bramhut/FlexBMS/Software/Companion/README.md

# FlexBMS Companion

The FlexBMS-only Companion has two compile-time targets. `npm run build:webserial`
creates the direct USB/Web Serial development build; `npm run build:gateway`
creates the committed ESP32 Gateway bundle under `dist/gateway` and its manifest.

The Gateway serves the latter on the trusted local LAN only. It is not an HV
safety authority. The Firmware page supports Gateway-assisted updates from a
FlexBMS bundle; STM32 updates require the station LAN. USB/ST-Link release
flashing remains available for recovery. The Web Serial target uses the same CRC-framed BMS v1 protocol as the
Gateway UART link; it requires a Chromium-family browser with Web Serial.

The Gateway target also exposes **Configuration > RS485 energy meters** for
the optional zero/one/two SDM72D-M-2 extension. Configuration is Gateway-local,
persists without a reboot, and requires the trusted station LAN. Direct USB
does not expose this capability. See the
[meter specification](../../Documentation/architecture/rs485-energy-meters.md)
for settings, reported values, HA discovery and commissioning.

The views share a responsive layout in both builds. Configuration groups the
battery, current sensor, and operating settings, shows unsaved changes, and
offers **Discard changes**. Shunt settings appear only when current sensing is
enabled. Wi-Fi and MQTT show connection summaries with explicit **Edit** forms;
live Gateway status updates preserve an open MQTT draft. Technical information
remains available in expandable details. Slave labels use numbering from 1 in
the UI; register requests and CSV indices retain their zero-based protocol form.

For a local UI preview, run `npm run dev -- --host 127.0.0.1 --port 5178` and open
`http://127.0.0.1:5178/tests/ui/companion.html`. It renders the actual view
components with sample telemetry and mock services. Preview controls exercise
connection loss, unavailable capabilities, configuration drafts, faults,
activity, and CSV snapshots. Local firmware bundles can be inspected, but
installation is blocked. This fixture is excluded from production builds.

`npm run build:desktop` produces a portable Windows executable below a new
timestamped `electron-dist/build-*/` directory and prints its exact path. It is
a thin Electron/Chromium wrapper around the direct USB Web Serial target: it
has no installer, updater, or native serial-protocol implementation. It is
deliberately unsigned and disables Electron-builder's Windows executable
signing/resource-editing pass, so packaging does not wait on `signtool`.
`../../scripts/build-release.ps1` builds that executable, the Gateway factory
image, and the STM32 image together, then writes them and SHA-256 hashes below
`release/FlexBMS-<version>/`. When run interactively, it prompts for the
release version; entering a new semantic version updates `package.json` and
`package-lock.json` before building. Use `-Version 0.1.1` for unattended use.
An existing version requires an explicit timestamped-repeat choice, so prior
artifacts are never overwritten.

Every release directory includes `flash-release.ps1`. Use `-Target Stm32` with
an ST-Link/SWD connection, `-Target Gateway -GatewayPort COM6` for the ESP32-C3
USB bootloader, or omit `-Target` to flash both. The script verifies release
hashes before erasing and flashing either controller.
