bramhut/FlexBMS/tmp/pdfs/bms-report-35.png

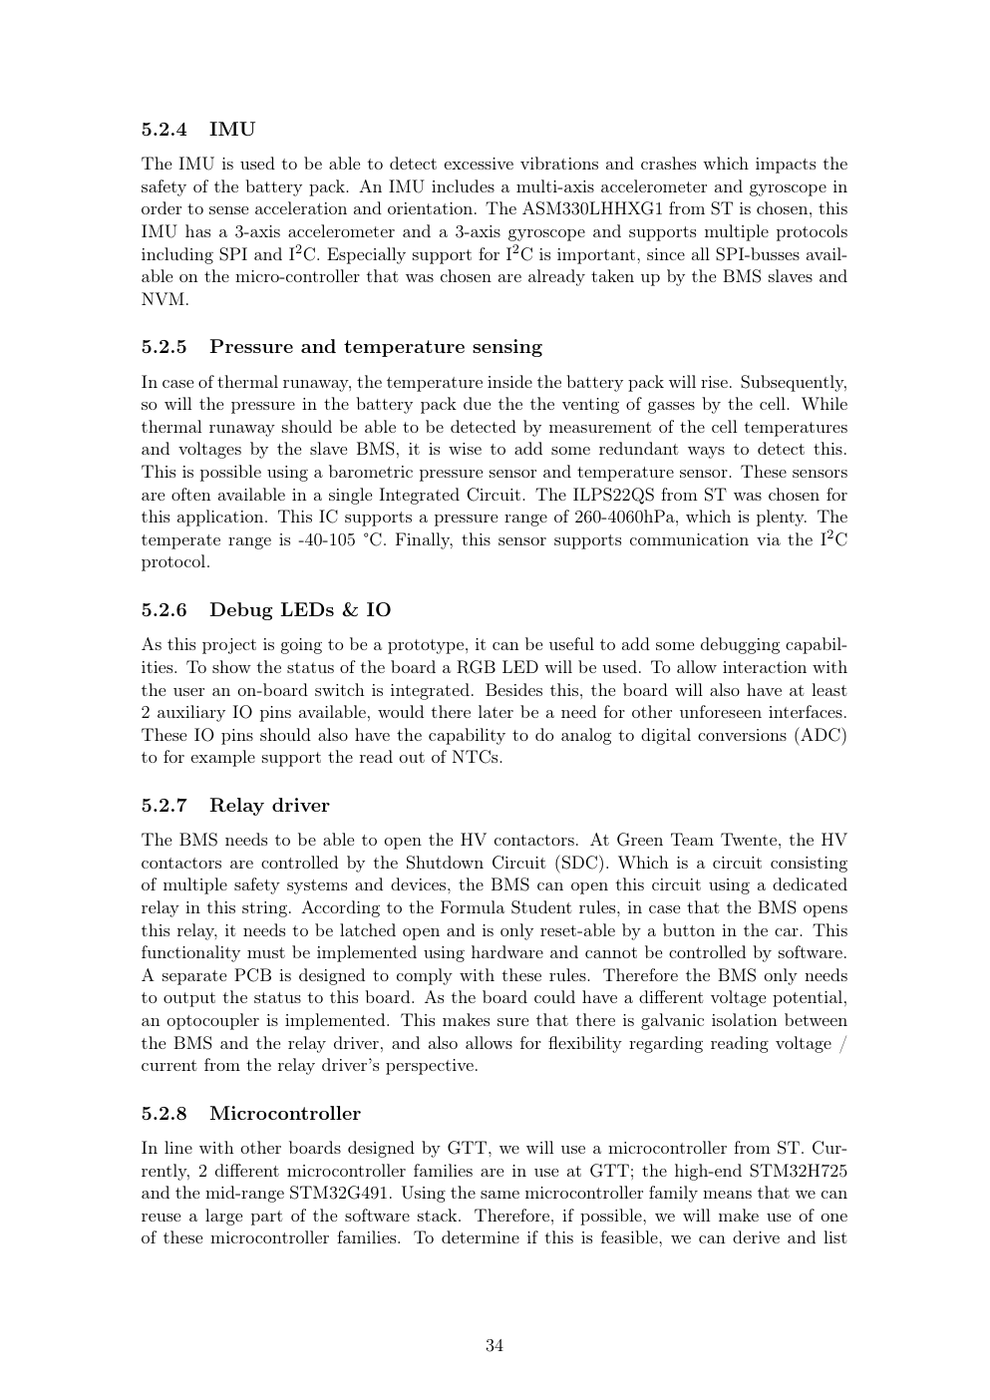
tmp/pdfs/bms-report-35.png
