bramhut/FlexBMS/tmp/pdfs/bms-report-36.png

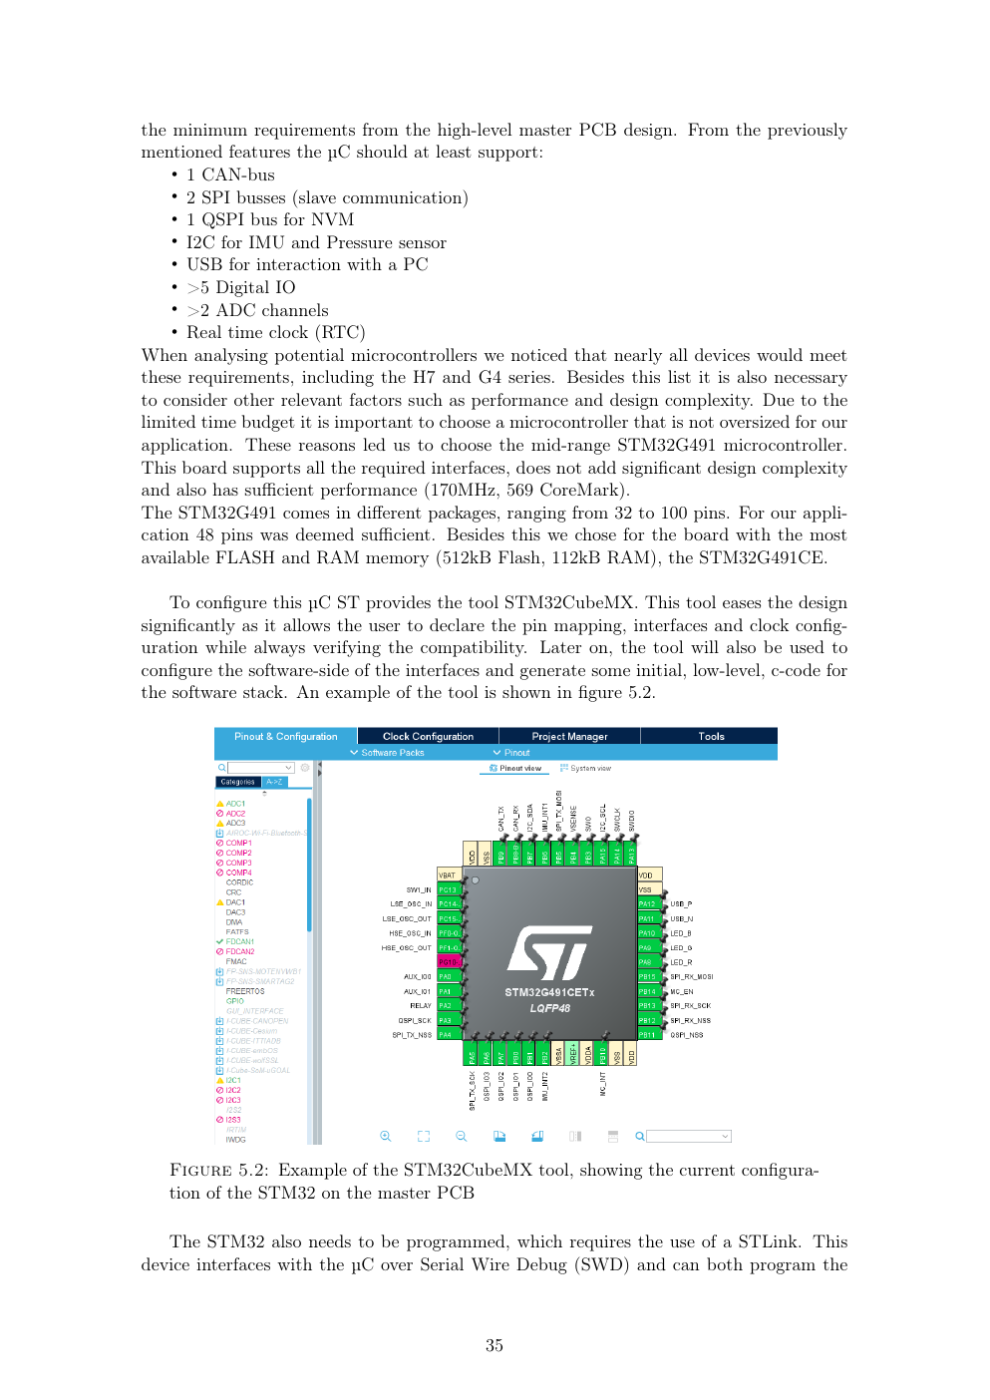
tmp/pdfs/bms-report-36.png
