bramhut/FlexBMS/tmp/pdfs/bms-report-37.png

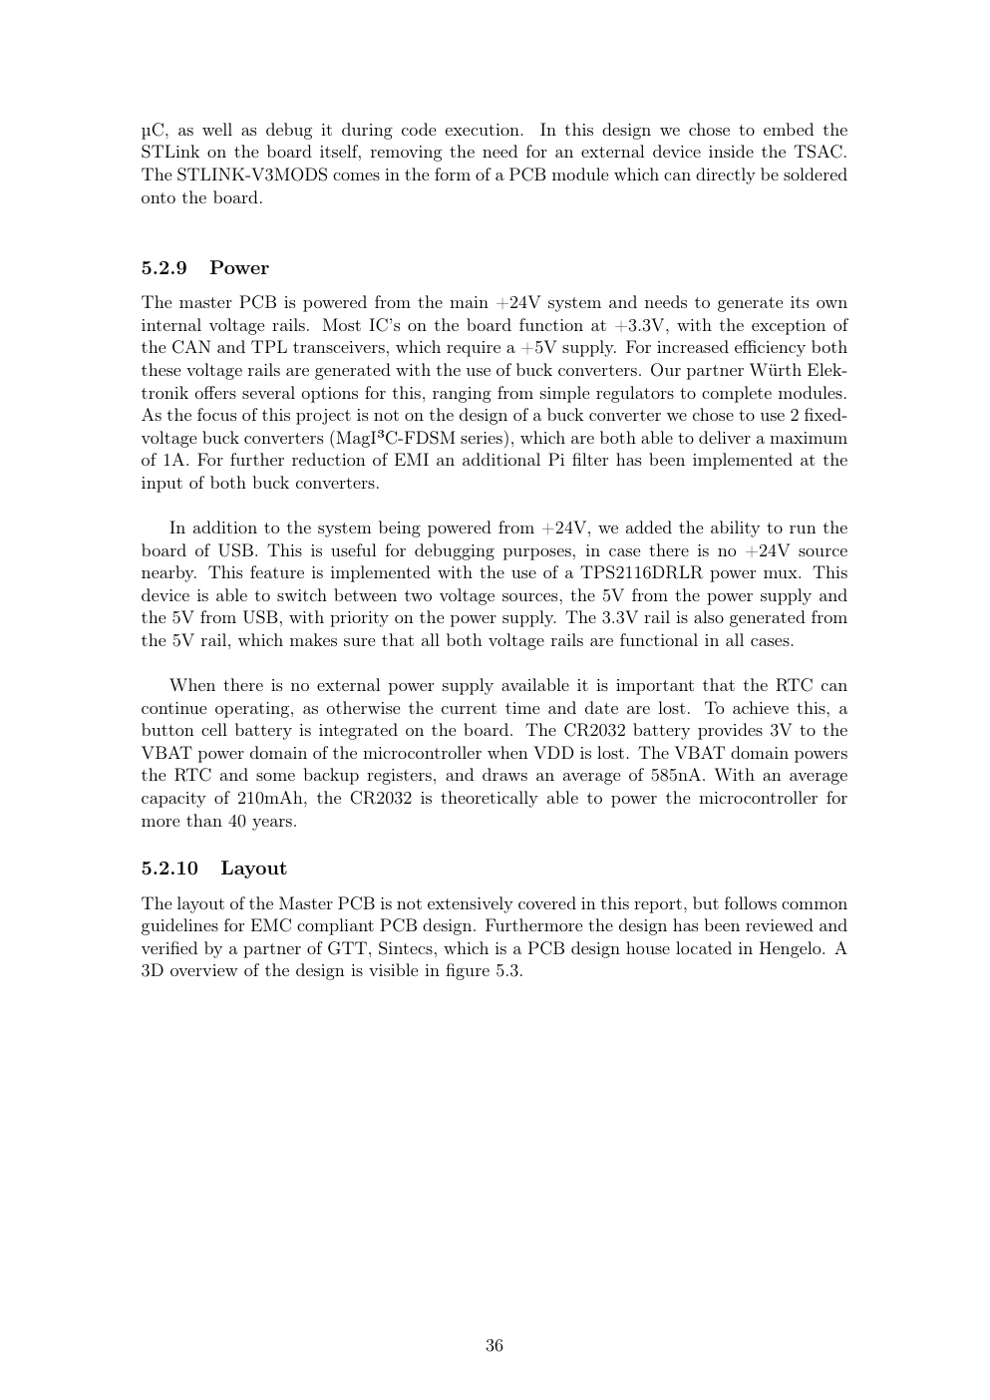
tmp/pdfs/bms-report-37.png
