bramhut/FlexBMS/tmp/pdfs/bms-report-38.png

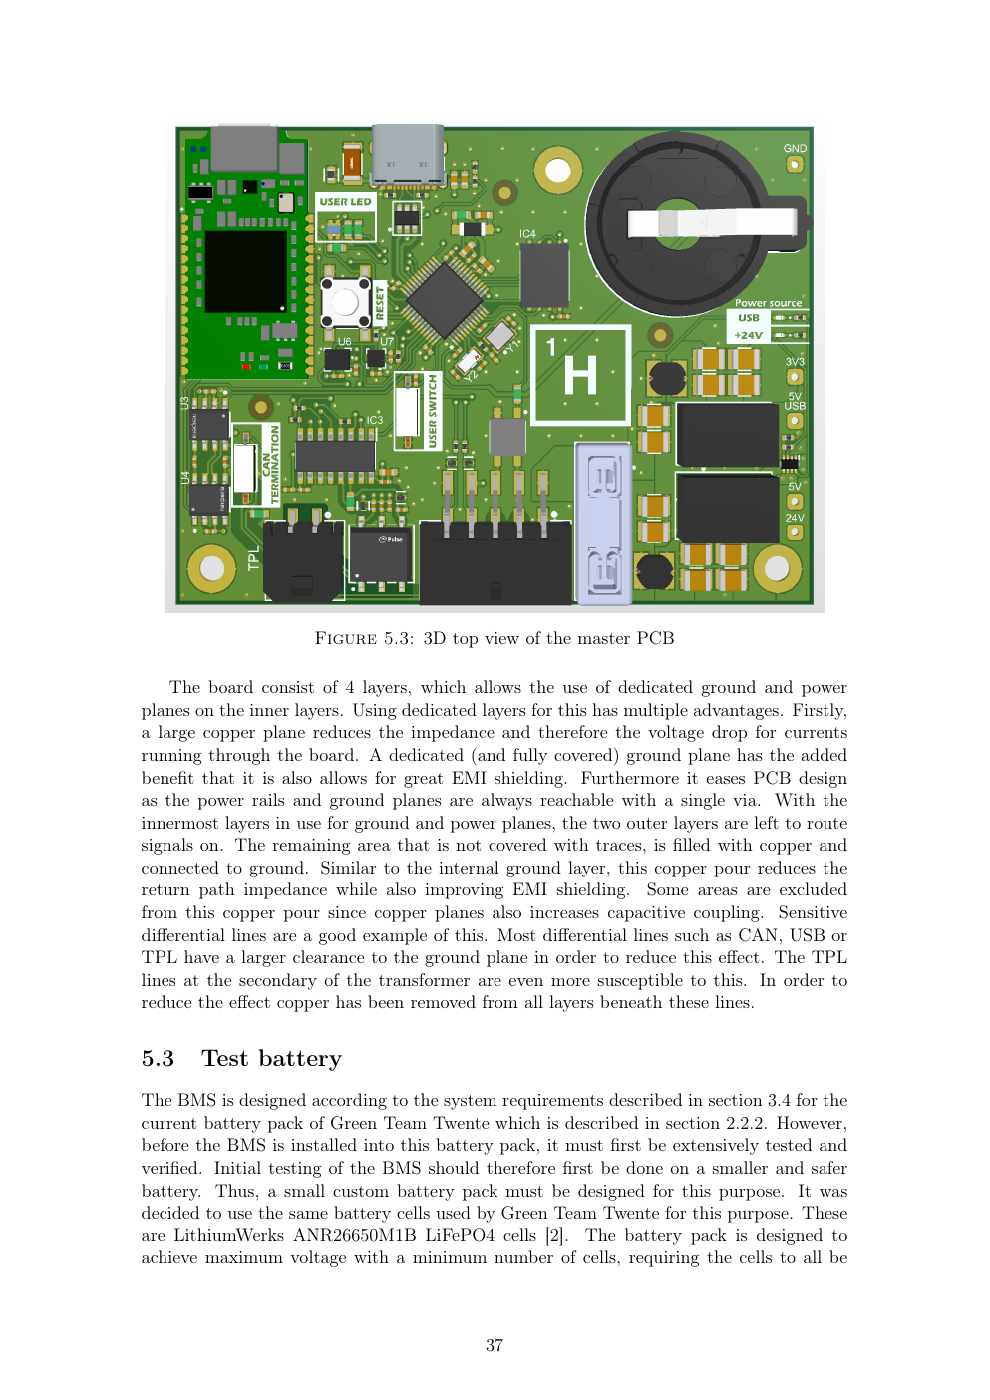
tmp/pdfs/bms-report-38.png
