bramhut/FlexBMS/tmp/pdfs/overview-12.png

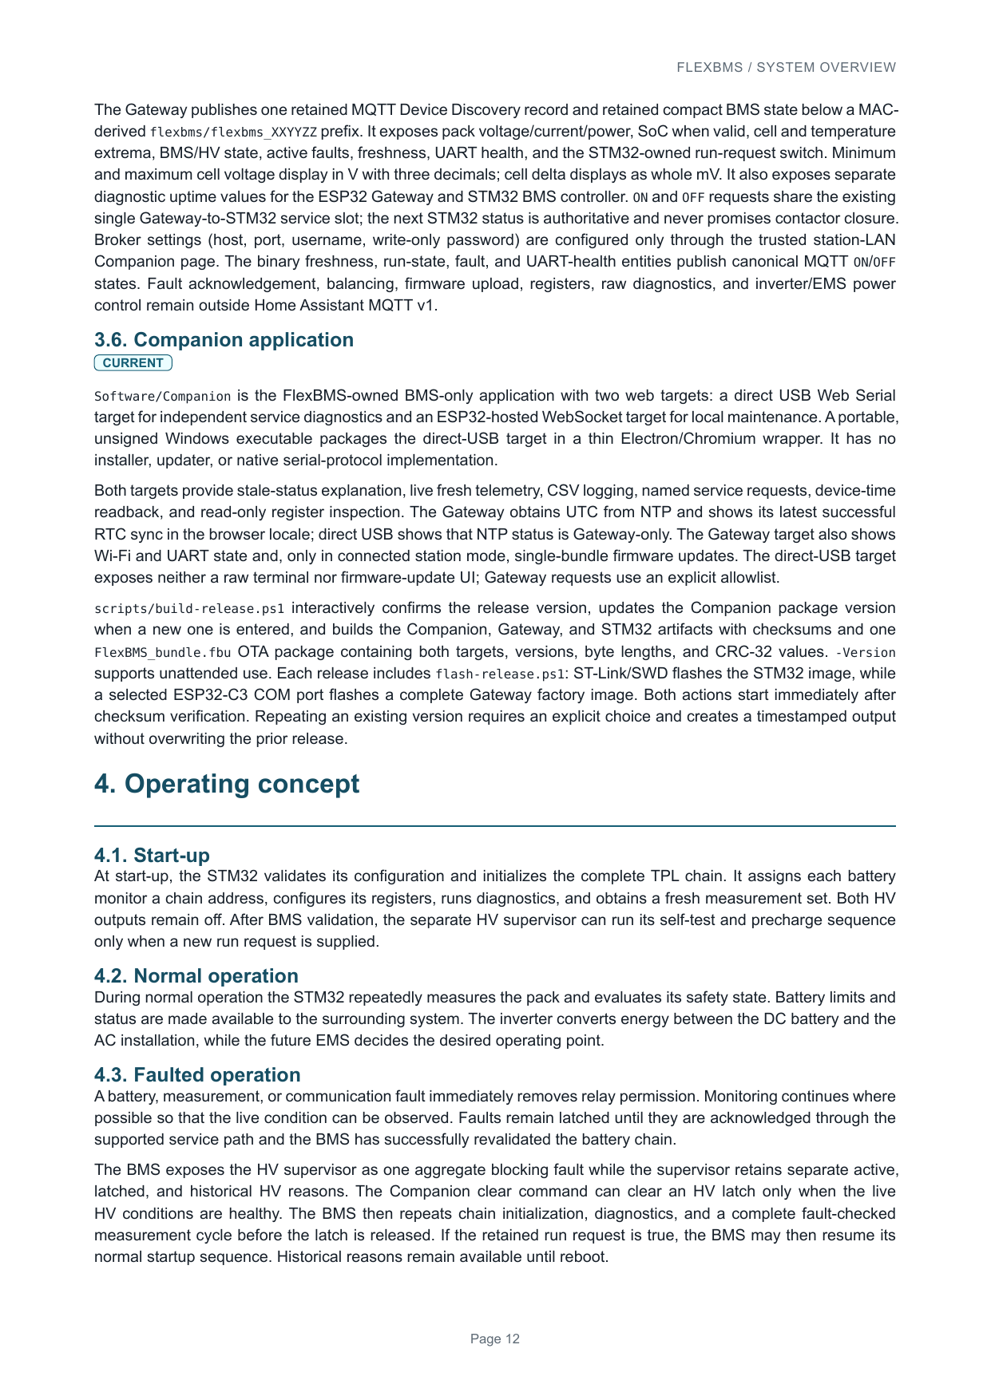
tmp/pdfs/overview-12.png
