bramhut/FlexBMS/Documentation/architecture/home-bess-firmware-and-maintenance.md

# Home-BESS firmware and maintenance architecture

## Status and scope

This is the agreed target architecture for FlexBMS Home-BESS software. It is a
design document, not a statement that the described ESP32, update, or web
software exists yet. It does not change the hardware safety chain.

The STM32G491 BMS communicates with the GoodWe GW12K-ET-20 over CAN. The
ESP32-C3 connects to the STM32 through the existing isolated UART link. The
ESP32 may passively observe the shared BMS/GoodWe CAN bus for diagnostics, but
never transmits on it.

## Safety and ownership

| Component | Owns | Does not own |
|---|---|---|
| STM32 BMS | Measurements, fault evaluation, HV permission, contactor safety, GoodWe CAN, final validation of all service requests | Wi-Fi, MQTT, Home Assistant availability |
| ESP32 Gateway | Local network, MQTT, web service, UART transport, ESP32 OTA, STM32 update orchestration | Battery safety decisions and BMS/GoodWe CAN transmission |
| FlexBMS Companion | Independent maintenance UI and named diagnostics/service requests | Raw network commands or safety decisions |
| Home Assistant | Dashboards, notifications, firmware/status display, maintenance-page link | Firmware upload, contactor control, or any safety dependency |

Loss of the ESP32, Wi-Fi, MQTT, Home Assistant, or the browser must never
prevent the STM32 from protecting or isolating the battery.

## Gateway Wi-Fi maintenance path

Wi-Fi configuration is an ESP32/Gateway maintenance function, not a battery
control path. The Gateway-hosted Companion can change credentials while it is
on the trusted LAN and can recover through an open, temporary setup AP. Neither
operation is sent to the STM32 or changes its safety ownership.

On first use the Gateway exposes `FlexBMS-Setup-XXYYZZ` at `192.168.4.1` until
configured. After a saved station network fails to acquire an IP for 30
seconds, it exposes the same AP for ten minutes while retrying station mode;
it then retries station-only for one minute and repeats until connected. The
AP offers best-effort captive-portal DNS/HTTP behaviour, although users may
need to open `http://192.168.4.1` manually on HTTPS-only clients.

The AP is deliberately open and credentials reside in ordinary ESP32 NVS.
While it is active, the Companion is monitor and Wi-Fi-configuration only:
Gateway-to-STM32 service controls are disabled. Detailed API and validation
requirements are in the Companion/Gateway specification.

## Operating request

The STM32 owns one volatile `run_request` flag. Both Companion transports and
the later Home Assistant switch use the same named `setRunRequest(true|false)`
operation; it is intent, never a direct contactor command.

The STM32 may operate the HV path only when `run_request` is true and all BMS
and HV-supervisor conditions are healthy. It is the STM32, not the requesting
client, that advances `OFF -> SELF_TEST -> PRECHARGE -> CONTACTOR_CLOSE -> RUN`.

A blocking fault immediately removes effective HV permission but does not erase
`run_request`. After the user explicitly clears faults and the STM32 completes
its required revalidation, the BMS may resume the startup sequence when the
request is still true. Switching the request off never clears faults.

The flag defaults off only after an STM32 reset. The Gateway serialises
state-changing requests so there is one active writer while any number of
clients may monitor. Telemetry must report the requested state, actual HV
state, and a concise blocking/rejection reason separately.

## Startup diagnostics and remote inspection

Startup diagnostics validate the monitor chain before fresh measurements and
HV readiness are available. They run independently of the volatile Run request;
passing diagnostics does not enable HV.

Each slave's configured temperature inputs occupy GPIO0 through
GPIO(NTC_COUNT-1). The GPIO open-terminal test retains the raw result for all
seven GPIOs, but only an open configured temperature input fails startup.
For example, four fitted inputs give a checked mask of `0x0F`; an open mask of
`0x70` identifies unused GPIO4–6 and is expected. An open mask containing any
bit in `0x0F` still blocks startup.

Failed diagnostics use a non-blocking two-second retry delay, then repeat
device initialization, CID assignment and register initialization. The delay
exceeds the monitors' 1024 ms communication-reset timeout, so diagnostic retries
must not reuse the old CID assignments or modified diagnostic registers.

ADC conversion waits compare unsigned elapsed times from the per-slave and
global conversion starts. This keeps retained startup-test timestamps valid
across the 32-bit microsecond timer's approximately 71.6-minute rollover.
The wait is limited to the remaining conversion duration; an already elapsed
conversion adds no delay. The 500 ms safety watchdog remains unchanged.

Companion's **Diagnostics → Hardware & tools** view shows the startup reports,
including register context and the raw/checked GPIO masks. Opening Diagnostics
refreshes the reports, including successful results. The first failed result
per slave is retained until STM32 restart so later communication failures cannot
replace it. Reports are historical; the dashboard's Status reports live faults.
Read-only register requests are serviced between startup/retry iterations by
the BCC task that already owns the SPI interface.

For Gateway-only investigation, run the following from the repository root:

```powershell
.\scripts\read-startup-diagnostics.ps1 -GatewayUrl http://GATEWAY_ADDRESS/ -OutputPath diagnostics.json
```

The capture reads controller versions, runtime configuration, status and each
slave's diagnostic report over the Gateway WebSocket. It does not change Run,
configuration or fault acknowledgements. Each service result is included;
`busy` or `denied` is not a passed diagnostic. `status_observed_at` timestamps the
status sample; `captured_at` and `completed_at` bound the whole capture.
`-TimeoutSeconds` sets a bounded capture deadline (60 seconds by default).
The wire fields and compatibility forms are specified in
[`../protocol/uart-v1.md`](../protocol/uart-v1.md).

## Repository layout and release ownership

FlexBMS owns the BMS-only Companion source because it releases alongside the
STM32 and Gateway interfaces. The external HyDriven Companion remains useful
as historical/reference code, but is not a release dependency or submodule.

~~~text
Software/
  Master/                 STM32 BMS firmware
  Gateway/                ESP32 firmware, MQTT, HTTP/WebSocket, OTA, UART bridge
  Companion/              FlexBMS-only Vue maintenance application
    src/                  shared BMS UI and transports
    dist/                 versioned generated bundles consumed by Gateway builds
  protocol/               transport specification, message catalogue, test vectors
Documentation/
  architecture/          this architecture
  operations/            commissioning, update, and recovery procedures
~~~

The obsolete in-tree Companion copy has been removed. A Gateway release
consumes a versioned committed Companion bundle so a local Gateway build
remains offline and reproducible.

## Companion: one UI, two web targets

The shared UI has a transport interface for connection lifecycle, live messages,
named requests, and declared capabilities. BMS views do not depend on the
physical transport.

~~~text
FlexBMS Companion shared BMS UI
  |- companion-webserial: Chromium Web Serial -> USB -> STM32
  |- companion-gateway:  Browser WebSocket -> ESP32 -> isolated UART -> STM32
  '- companion-desktop:  Portable Electron/Chromium wrapper -> Web Serial -> USB -> STM32
~~~

companion-webserial is the direct-service fallback. It exposes the same named
BMS actions as the Gateway build and has no raw-terminal or firmware-update
interface.

companion-desktop packages the direct-USB target as a portable, unsigned
Windows executable. It is not an installer and has no updater or native serial
protocol implementation; Electron provides Chromium and Web Serial only.

companion-gateway is the ESP32-hosted local maintenance page. It provides
monitoring, named service actions, Gateway status, and Wi-Fi configuration. It
does not include a raw terminal and the Gateway rejects unknown or raw requests
even if a browser client attempts to send them.

Both builds support stale-status explanation, live BMS monitoring, register
reads, Gateway NTP RTC sync and device-time readback, fault-clear requests,
the immediate BMS run-request switch, browser-local CSV logging, and a live
GoodWe CAN diagnostic panel. The panel shows STM32 TX-queue acceptance/timing,
transmit failures, FDCAN error counters and bus state, skipped CAN cycles, the
exact current sent in `0x458`, and raw inverter responses `0x420`, `0x425`, and
`0x305`; the same data is included in the CSV log. The Gateway build additionally offers Gateway
Wi-Fi/link diagnostics. Its page prominently identifies the active connection
as either Direct USB to STM32 or Via ESP32 Gateway and disables capabilities
not available on that path.

The FlexBMS build removes HyDriven branding, unrelated vehicle-device views,
and Electron self-update UI. The initial stored Gateway bundle budget is 500
KiB. This is below the measured approximately 940 KiB stored size of the
unmodified multi-device Companion build. `scripts/build-release.ps1` runs the
Companion checks, packages the desktop executable, builds Gateway firmware,
and places `FlexBMS-Companion.exe`, `FlexBMS-Gateway.bin`,
`FlexBMS-Gateway-factory.bin`, `FlexBMS-STM32.bin`, `flash-release.ps1`, and
`SHA256SUMS.txt` in `release/FlexBMS-<version>/`. The interactive command
prompts for a plain `major.minor.patch` version and synchronizes it to the Companion
package files and STM32 version header; `-Version` supports unattended builds.
Existing release directories are preserved: increment the patch version for a
new build. Release names have no timestamp or version suffix. The script does
not flash hardware.

`flash-release.ps1` is copied into every release directory. It verifies all
release checksums before acting, then uses STM32CubeProgrammer over ST-Link/SWD
to write and verify the STM32 application at `0x08000000`. For the ESP32-C3 it
uses `esptool.py` on a chosen COM port to erase and flash the complete Gateway
factory image. Flashing starts immediately after checksum verification; close
serial monitors and manually enter the ESP32-C3 bootloader when necessary.
The factory-image builder takes the Gateway application address from the
`ota_0` row in `Software/Gateway/partitions.csv` (currently `0x20000`), rather
than using ESP-IDF's conventional `0x10000` default. It verifies that the
merged factory image contains the ESP image magic at that exact address before
writing release checksums. Normal PlatformIO Gateway uploads use the same
partition-derived offset.

## Gateway web and network service

The ESP32 serves the Gateway Companion bundle and its API on the trusted local
LAN. It uses unauthenticated local HTTP and WebSocket by design; the router
must not expose the device to the Internet. A local page is preferred to an
externally hosted UI because it remains usable without Internet, Home
Assistant, or a separate server.

When unprovisioned, the Gateway provides a temporary setup access point and
setup page. After credentials are stored it uses station mode on the local LAN.

Named Gateway service actions in the first release are:

- read a BMS register;
- synchronise the RTC;
- set the BMS run request;
- submit a fault-clear request; and
- configure or scan local Wi-Fi through the Gateway when its Wi-Fi capability
  is available.

Full runtime configuration writes are permitted only through the local
Companion service path while the HV system is safely off. The STM32 validates
and stores the complete candidate in its reserved FLASH area, applies it after reset, and
enters a blocking `NO_CONFIG`/safe-off state when the area is blank or its
schema version is incompatible. A single deliberate button press is
sufficient for a permitted local action; the STM32 remains responsible for
validating every requested state change. Wi-Fi, browser, MQTT, and Home
Assistant loss have no BMS safety effect in this stage.

## MQTT and Home Assistant

The Gateway uses Home Assistant MQTT Device Discovery, so Home Assistant needs
no YAML configuration. Its identity and state prefix are derived from the
Gateway Wi-Fi MAC as `flexbms/flexbms_XXYYZZ`; Discovery uses the standard
`homeassistant` prefix. The intended broker is the official Mosquitto Broker
add-on on Home Assistant OS. The Companion stores a normal local-broker host,
port, username, and write-only password in Gateway NVS. MQTT configuration is
available only on the trusted station LAN, never through the open setup or
recovery AP. The ESP32 reconnects when the broker returns and republishes
current discovery and diagnostic state after reconnect. Home Assistant, the broker, and
MQTT are not BMS safety dependencies.

Discovery/configuration and the combined diagnostic snapshot are retained. Gateway
availability uses MQTT last-will/offline status. An unavailable Gateway marks
the Home Assistant entities unavailable but does not alter the STM32 request or
safety state.

Home Assistant receives only compact aggregate telemetry and the maintenance
link; detailed cells, balancing state, registers, raw diagnostics, and the 128
KiB Gateway log remain in Companion. The initial entity catalogue is:

| Entity | Meaning |
|---|---|
| `switch.run_request` | Requested BMS operation only; never a contactor-state guarantee. |
| `sensor.hv_state` and `binary_sensor.hv_running` | Actual STM32 HV-supervisor state; `hv_running` is true only in `RUN`. |
| Pack sensors | Pack voltage, current, power, and SoC when valid; minimum/maximum cell voltage display in V with three decimals; minimum/maximum NTC temperature. |
| `sensor.cell_delta` | Maximum minus minimum cell voltage, published and displayed as whole mV. |
| `binary_sensor.fault_active` | On whenever any active or blocking BMS fault exists. |
| `sensor.active_faults` | Human-readable active fault names, or `No faults`. |
| Link sensors | ESP32 Gateway uptime, STM32 BMS-controller uptime, UART health, telemetry freshness, MQTT state, and Gateway availability. |
| Maintenance-page link | The discovered device links to the local Gateway Companion page. |

The `run_request` switch reports the STM32-owned retained intent. Its MQTT
command topic accepts only `ON` and `OFF`, is never retained, and shares the
Gateway's one active STM32 service slot with Companion and NTP. The Gateway
does not report an optimistic switch result: the next STM32 `STATUS` is the
authoritative state. Separate HV and fault entities show whether that intent is
presently effective. Home Assistant does not upload images or directly initiate
safety-related actions.

The four binary diagnostics (`telemetry_fresh`, `hv_running`, `fault_active`,
and `uart_healthy`) publish canonical MQTT `ON`/`OFF` states. Home Assistant
therefore reports a real state rather than `Unknown`; `fault_active` is `ON`
only for an active/blocking BMS or HV fault. Gateway uptime is the ESP32
microsecond timer converted to seconds; BMS-controller uptime is the STM32
`STATUS.uptime_ms` tick converted to seconds. Both reset on their respective
controller reset and are diagnostic only.

### Acquisition-based HA publishing (local increment, 12 October 2026)

The MQTT discovery identities, entity names, device identity and command topic
are unchanged. Acquisition-sensitive entities now override the common state
topic with one of the following topics beneath `flexbms/flexbms_XXYYZZ`:

| Topic | Entities / source |
|---|---|
| `state/status` | Run request, BMS/HV state, HV running, faults, telemetry freshness and STM32 uptime; newly decoded STATUS only |
| `state/pack` | Pack voltage/current/power/SoC, cell extrema and temperatures; newly decoded PACK only |
| `state/energy` | Charged/discharged energy; newly decoded ENERGY only |
| `state` | Legacy combined diagnostic snapshot and Gateway link diagnostics; **not acquisition proof** |

Live source packets are non-retained QoS 0: a missed packet waits for the next
UART acquisition rather than replaying an old QoS-1 outbox entry after reconnect.
The Gateway coalesces each source's newest decoded frame into its existing
one-second publication cycle. It consumes that source only when publication is
accepted; a failed local send may retry while the acquisition is under three
seconds old. Periodic ticks, unrelated frames and discovery cannot publish a
cached source. PACK/ENERGY require a recent STATUS with measurements-fresh set.
Malformed frames do not mark a source acquired. Invalid measurement status,
UART loss, MQTT reconnect/disconnect and HA birth discard pending acquisitions.
Fresh STATUS alone cannot resurrect a discarded PACK or ENERGY.

Live sensors/binary sensors use `force_update: true` for unchanged successful
acquisitions and a provisional ten-second expiry. The run-request switch has no
force-update or expiry option: its attributes carry the existing STATUS
`stm32_uptime_ms`, so unchanged intent receives a real HA write on a new status
tick. Its old displayed value is not readiness; consumers must enforce source
age. There is no new entity, heartbeat counter or UART schema. See the official
[MQTT sensor](https://www.home-assistant.io/integrations/sensor.mqtt/),
[binary sensor](https://www.home-assistant.io/integrations/binary_sensor.mqtt/)
and [switch](https://www.home-assistant.io/integrations/switch.mqtt/) contracts.

The existing STM32 sends PACK only after `tryGetNewMeasurementFrame` accepts a
new measurement sequence; STATUS comes from the BMS task at 500 ms intervals.
No STM32 safety logic, acquisition path or firmware was changed here. Timestamps
remain HA receipt times, not synchronized physical-acquisition times. Network
delay, restored HA states and publisher compatibility still require commissioning.
Direct subscribers to legacy `state` must not treat it as a live acquisition.

Native tests exercise the real `MqttClient.cpp`, real UART decoder and cJSON
with fake ESP/network calls, plus the pure publication gate and pack/schema
regression. Run with GCC under Linux/WSL from the repository root:

```text
bash Software/Gateway/tests/run-mqtt-tests.sh PATH_TO_ESP_IDF/components/json/cJSON
```

The ESP-IDF directory is the configured PlatformIO framework location on that
PC. Test artifacts use a unique temporary directory. The local Gateway firmware
build also passes. This increment is **not flashed or hardware-commissioned**;
there is no release/version publication. Before relying on `last_reported`,
verify unchanged run/HV/fault reports, unchanged power, pack-read loss while
STATUS continues, UART loss, broker/HA restart and recovery on the installed
Gateway. Compare acquisition age and cadence without commanding battery transfer.

## Optional RS485 energy meters

The Gateway also supports an optional read-only RS485 extension for up to two
SDM72D-M-2 energy meters. It reports phase currents and signed phase/total power
every second, import/export counters every 30 seconds, and discovers a separate
HA device for each enabled slot. Per-meter names, slave addresses, reverse power
direction, and shared serial settings persist locally. It uses UART0 and the
existing RS485 interface independently of the STM32 UART1 link; it does not
regulate the inverter or change BMS safety decisions. See
[RS485 energy meters](rs485-energy-meters.md) for the implementation contract,
freshness rules, and commissioning checks. The extension is disabled by default
and its configuration is unavailable over the open recovery AP or direct USB.

## Status LED language

The STM32 red and green status LEDs are active-low. The Gateway has one
active-high yellow `USR_LED` on IO1/GPIO1 (ESP32-C3-WROOM-02U module pin 17).
GPIO17 is not exposed by this module. The STM32 yellow LED is the USART1 TX
line and must not be used as an indicator. The STM32 red/green LEDs implement
the status language below; their active-low PWM handling is local to the
STM32 board-I/O layer.

The two controllers use the same *temporal* language and, while the UART is
healthy, the Gateway follows the STM32 phase. Each STM32 `STATUS` carries its
uptime every 500 ms or faster; the Gateway extrapolates that timestamp between
frames and uses it for the shared 2-second patterns. This keeps common pattern
edges aligned within normal UART and scheduling latency, while correcting clock
drift without a new wire format. On UART loss the Gateway falls back to its
local phase, so the two endpoints cannot remain synchronised during code 3.
Different controller states may deliberately use different patterns.

| Pattern | Timing | Common meaning |
|---|---|---|
| Boot acknowledgement | Solid for 1 s | Firmware has started. |
| Waiting | 500 ms on / 500 ms off | Startup or a required prerequisite is not yet ready. |
| Healthy heartbeat | 100 ms on every 2 s | Ready and healthy, but not actively operating. |
| Code 2 | Two 150 ms flashes, 150 ms apart, every 2 s | A non-safety external service is unavailable. |
| Code 3 | Three 150 ms flashes, 150 ms apart, every 2 s | STM32--Gateway UART link unavailable. |
| Update | 4 Hz blink | Firmware update preparation or transfer is in progress. |
| Fatal local failure | Solid after the boot acknowledgement | The local firmware cannot enter normal operation. |

Colour adds STM32-specific context without changing these patterns. The STM32
uses green for healthy and transition/update states, and red for an active
blocking BMS condition. The Gateway uses its single yellow LED for all Gateway
states. In particular, a UART-loss BMS communication fault is three red
flashes; the Gateway shows the same three-flash code in yellow. Any other
active blocking BMS fault is a single red flash every two seconds. The full
fault bitmap is intentionally not encoded into flash counts;
Companion and Home Assistant remain the source of the exact fault names.

The initial state mapping is:

| Controller | State | Indication |
|---|---|---|
| STM32 | Boot / self-test before ready | Green waiting blink after the boot acknowledgement. |
| STM32 | Healthy `OFF`, no run request | Green healthy heartbeat. |
| STM32 | `SELF_TEST`, `PRECHARGE`, or `CONTACTOR_CLOSE` | Green waiting blink. |
| STM32 | `RUN` | Solid green. |
| STM32 | Active blocking fault other than UART loss | Single red flash every 2 s. |
| STM32 | UART-loss fault | Code 3 in red. |
| Gateway | Boot | Yellow boot acknowledgement. |
| Gateway | Wi-Fi setup or connecting to Wi-Fi | Yellow waiting blink. |
| Gateway | Wi-Fi connected, MQTT unavailable | Code 2 in yellow. |
| Gateway | Wi-Fi, MQTT, and STM32 UART healthy | Yellow healthy heartbeat. |
| Gateway | UART heartbeat timeout | Code 3 in yellow. |
| Gateway | Firmware update in progress | Yellow update blink. |

The STM32 LED controller and Gateway LED controller must be non-blocking,
driven from their regular scheduling loops, and apply the highest-priority
active state. For the STM32: fatal local failure, blocking fault, update,
startup transition, `RUN`, then ready-off. For the Gateway: fatal local
failure, update, UART loss, Wi-Fi setup/connecting, MQTT loss, then healthy.
An ordinary BMS fault is not a Gateway fault indication unless it is the
UART-loss condition: the Gateway remains healthy and reports the BMS fault
through Companion and Home Assistant.

Brightness is independently adjustable for every physical LED: STM32 red,
STM32 green, and Gateway yellow. These values are named firmware configuration
constants rather than hard-coded in pattern logic. They define the maximum
duty/drive used by every normal operational pattern and default below full
brightness; commissioning may tune each LED independently. The STM32
controller inverts its logical on/off pattern for its active-low hardware; the
Gateway drives its active-high LED directly. An optional separately capped
attention brightness may be used for boot acknowledgement and
fatal-local-failure indication, also below the hardware maximum.

## Telemetry and event contract

UART telemetry uses raw integer units; the Gateway converts the compact Home
Assistant values to engineering units (V, A, degrees Celsius, and percent) with
sensible display rounding. The initial cadence is:

| Data | STM32 to Gateway | Gateway to MQTT / Home Assistant |
|---|---:|---:|
| BMS/HV state, fault state, and `run_request` | 2 Hz STATUS (plus new measurement set) | Up to 1 Hz after new STATUS, including unchanged values |
| Pack voltage/current/SoC and min/max values | Up to 2 Hz, new measurement set only | Up to 1 Hz after new PACK, including unchanged values |
| AMC3330 BAT+ and LOAD+ voltage readings | Every fresh BMS set | Companion only |
| Per-slave cell voltages and balancing | Every fresh BMS set | Companion only |
| Per-slave temperatures | Every fresh BMS set | Companion only |
| UART health and telemetry freshness | 1 Hz | 1 Hz |
| Firmware versions | On boot/change | Retained |
| Fault, UART, and HV transition events | Immediately | Immediately |

The Gateway publishes individual BMS event messages to MQTT in addition to
maintaining the current `fault_active` and `active_faults` entities. This
supports Home Assistant history and automations without making events a BMS
safety dependency. UART v1 events contain an ID and value only, so v1 MQTT
events carry Gateway uptime rather than claiming an STM32-originated wall-clock
timestamp.

## Framed BMS protocol

The canonical byte-level specification is
[`Documentation/protocol/uart-v1.md`](../protocol/uart-v1.md). It defines the
framing, CRC, numeric IDs, payload layouts, integer scales, fault/event
mappings, service result values, ROM-bootloader handoff, and test vectors. It
supersedes the earlier provisional UART description that appeared here.

The isolated UART link is 1 Mbit/s. Direct USB CDC uses the exact same framed
protocol for the standalone Web Serial Companion, while retaining the trusted
text command/debug console through a byte dispatcher. Telemetry is
unsolicited/latest-value data; one named STM32 service is active across both
links and has an explicit response. The STM32 sends raw integer values and
remains the safety authority. UART loss is a communication-health condition
only; it does not force the HV path off or change the run request.

## Firmware updates

`scripts/build-release.ps1` writes one `FlexBMS_bundle.fbu` OTA package. Its
`FBU1` header contains a compact JSON manifest followed by the STM32 and
Gateway raw images. The manifest identifies each target, semantic version, byte
length, and CRC-32. The station LAN is trusted: there are no release signatures
or login checks. CRC-32 detects corrupted storage and transfer; it is not an
authentication mechanism.

### ESP32 OTA

Only the station-LAN Gateway Companion page exposes firmware controls. The
operator selects `FlexBMS_bundle.fbu` and checks the STM32 BMS and/or ESP32
Gateway image shown by its manifest. Companion streams each selected raw image
to the target-specific Gateway endpoint; it completes STM32 first and the
rebooting Gateway last. Provisioning and recovery APs never expose update
controls. The Gateway checks the declared length and CRC-32 while streaming a
Gateway image into the inactive OTA slot, selects it for boot, acknowledges the
browser, and reboots. ESP-IDF rollback is enabled: the new slot remains pending
until the local HTTP/WebSocket service has started and the Gateway regains a
station address. If that cannot happen within one minute, it resets without
confirmation and the bootloader returns to the previous slot. Companion reports
the observed restart and reloads itself when the compiled web bundle changed.
Manual USB factory flashing remains the recovery path.

The fitted ESP32-C3-WROOM-02U-N4 has 4 MiB flash. `Software/Gateway/partitions.csv`
defines the accepted layout. Its two 1.5 MiB OTA application slots accommodate
the Gateway image and its committed, compiled Companion bundle with room for
the 500 KiB bundle limit. The table is:

| Partition | Offset | Size | Purpose |
|---|---:|---:|---|
| `nvs` | `0x9000` | 24 KiB | Wi-Fi credentials and small update metadata. |
| `otadata` | `0xF000` | 8 KiB | Selects the booted OTA slot. |
| `phy_init` | `0x11000` | 4 KiB | Wi-Fi PHY initialisation data. |
| `ota_0` | `0x20000` | 1.5 MiB | One ESP32 firmware image and its compiled Companion bundle. |
| `ota_1` | `0x1A0000` | 1.5 MiB | The other ESP32 firmware image and its compiled Companion bundle. |
| `bms_update` | `0x320000` | 512 KiB | Raw staging area for one complete STM32 image. |
| `littlefs` | `0x3A0000` | 384 KiB | Reserved future diagnostics and file metadata. |

ESP32 OTA streams a verified image directly to the inactive application slot;
it does not need a separate download partition. STM32 flash is at most 512 KiB
and is staged in the dedicated raw partition. The Gateway verifies its expected
length and CRC-32 before beginning the internal UART transfer.

The Companion bundle is compiled into both OTA application images, which keeps
each Gateway firmware/UI release atomic. The 1.5 MiB slots support the
512,000-byte bundle limit without LittleFS serving. `FlexBMS-Gateway.bin` is
the OTA artifact; the complete factory image remains for wired recovery only.

The application image must be written at `ota_0`'s explicit offset, currently
`0x20000`. `0x10000` is only ESP-IDF's generic default and is not an
application partition in this layout. Release tooling reads the CSV rather
than duplicating this value, so a future partition-table change also changes
the factory-image application address.

### STM32 update

The Gateway stages `FlexBMS-STM32.bin` in `bms_update` and checks its length
and CRC-32 before asking the STM32 to prepare update mode. The STM32 accepts
only from safe-off: run request off and HV outputs inactive. Prepare immediately
holds HV off and returns `OK`; it automatically expires after 3 seconds unless
the Gateway sends a response-free commit. Only commit takes the update lock and
jumps to the immutable system-memory bootloader on USART1 (PA9/PA10). Thus a
lost prepare response or a Gateway-local transmit failure leaves the STM32 in,
or returns it to, normal BMS operation rather than stranding it in update mode.

The ESP32 temporarily switches UART1 from framed 1 Mbit/s 8-N-1 to the STM32
ROM USART protocol, synchronises, verifies bootloader ID, erases application
flash, writes chunks, reads them back for CRC-32 verification, and issues `Go`
at the application address. It restores framed UART and reports completion only
after a new STM32 application heartbeat. Any failure
after erase begins is a wired STM32 recovery case; Gateway OTA is blocked until
an application heartbeat proves the STM32 has been recovered. BMS outputs
remain de-energised during the handoff.
