bramhut/FlexBMS/Simulations/balancing.asc

R_bal_c: res; 3.3
Rbal: res; 30
Rds: res; 0.5
V1: voltage; 3.3
Named nets: 0
.tran 1s
