bramhut/FlexBMS/(list of files, drawings)

Other design files:
Hardware/FlexBMS_lib.pcblib
Hardware/FlexBMS_lib.schlib
Hardware/Master/BMS_Master.PrjPcb
Hardware/Master/Connectors.SchDoc
Hardware/Master/ESP32.SchDoc
Hardware/Master/HV.SchDoc
Hardware/Master/HVsense.SchDoc
Hardware/Master/Master.PcbDoc
Hardware/Master/Peripherals.SchDoc
Hardware/Master/Power.SchDoc
Hardware/Master/RelayDriver.SchDoc
Hardware/Master/STM32_IO.SchDoc
Hardware/Master/Top.SchDoc
Hardware/Master/Transceivers.SchDoc
Hardware/MB/BMS_Master.PrjPcb
Hardware/ModuleBoard/BalancingNetwork.SchDoc
Hardware/ModuleBoard/Module Board.PcbDoc
Hardware/ModuleBoard/Module Board.SchDoc
Hardware/ModuleBoard/ModuleBoard.PrjPcb
Hardware/ModuleBoard/Slave.SchDoc
Hardware/Slave/Module Board.PcbDoc
