bramhut/FlexBMS/Software/Master/Src/Peripherals/bcc/SlaveController.cpp

#include "FirmwareVersion.h"

/*!
 * @file slaveController.cpp
 *
 * Controller for the slave devices in the TPL chain.
 */

/*******************************************************************************
 * Includes
 ******************************************************************************/

#include "TimeFunctions.h"
#include "RtcTime.h"
#include "main.h"
#include "FaultManager.h"
#include "EnergyCounter.h"
#include "BccBreadcrumb.h"
#include "Peripherals/BatteryBalancing.h"
#include "Peripherals/BalancingCharge.h"
#include "Peripherals/SelfDischarge.h"
#include "Peripherals/CurrentUnits.h"
#include "Peripherals/CurrentSensingPolicy.h"
#include "Peripherals/BatteryLimits.h"
#include "Peripherals/TemperatureLimits.h"
#include "Peripherals/BatterySoc.h"
#include "Watchdog.h"
#include "pcc.h"
#include "bcc/SlaveController.h"
#include "bcc/bcc_diagnostics.h"
#include "bcc/UserSettings.h"
#include "RuntimeConfiguration.h"
#include "USBCOM.h"
#include "FreeRTOS.h"
#include "semphr.h"
#include <algorithm>
#include <array>
#include <atomic>
#include <cmath>
#include <initializer_list>
#include <limits>
#include <span>

#define DEBUG_LVL 2
#include "Debug.h"

using std::vector;

/*******************************************************************************
 * Definitions
 ******************************************************************************/

/* NO NEED TO CHANGE THE SETTINGS BELOW */


/*! @brief Time after VPWR connection for the IC to be ready for initialization
 *  (t_VPWR(READY), max.) in [ms]. */
#define BCC_T_VPWR_READY_MS 5U
#define CID_INITIALIZATION_MAX_FAILURES 3U

constexpr uint8_t kCommunicationFailureTripCount = 3U;

namespace SlaveController
{
    namespace
    {
        /*******************************************************************************
            FreeRTOS Task stuff
        ******************************************************************************/
        osThreadId_t bmsTaskHandle;
        const osThreadAttr_t bmsTask_attributes = {
            .name = "bmsTask",
            .stack_size = 2048,
            .priority = (osPriority_t)osPriorityNormal,
        };

        /*******************************************************************************
         * Private variables
         ******************************************************************************/

        CAN *mCAN = nullptr; /* Pointer to the CAN instance */

        uint8_t registerInitializationFailureCount = 0U;
        uint8_t diagnosticsFailureCount = 0U;
        uint8_t tplInitializationFailureCount = 0U;
		uint32_t initializationRetryNotBeforeMs = 0U;
        std::array<bool, static_cast<size_t>(NO_CONFIG) + 1U> bmsFaultInputs{};

        std::atomic<BMSState> currentState{DEVICE_INITIALIZATION}; // Current state of the BMS

        static vector<BCC> mSlaves; /* Array of BCC devices */
        vector<uint8_t> cidInitializationFailureCounts;

        // Static firmware defaults contain safety limits and hardware timing.
        // Companion-configurable values live in this runtime/NV-backed object.
        const StaticSettings_t &settings = DEFAULT_STATIC_SETTINGS;
        bool activeConfigurationLoaded = false;
        RuntimeConfiguration::Values runtimeConfiguration = RuntimeConfiguration::defaults();

        uint16_t cBalancingTime = 0; // Time in [min] for a single cell balancing operation

        // Automatic balancing is enabled by default. This remains an additional
        // user-controlled gate and never overrides normal safety conditions.
        std::atomic<bool> balancingEnabled{true};
        std::array<uint16_t, RuntimeConfiguration::MAX_SLAVES> activeBalancingMasks{};
        std::array<uint8_t, RuntimeConfiguration::MAX_SLAVES> balancingSelectionStartIndices{};
        bool balancingHardwareStateKnown = false;
        bool balancingCycleActive = false;
        BatteryBalancing::CurrentQualification balancingCurrentQualification;
        uint32_t balancingCycleEndMs = 0U;
        std::array<BalancingCharge::Timeline, RuntimeConfiguration::MAX_SLAVES>
            balancingAccountingTimelines{};
        std::array<std::array<BalancingCharge::Counter, MAX_MEASUREMENT_CELLS>,
                   RuntimeConfiguration::MAX_SLAVES> balancingChargeMilliAmpMs{};
        SelfDischarge::CalibrationInterval selfDischargeInterval{};
        uint32_t selfDischargeLastTickMs{};
        SelfDischargeSnapshot publishedSelfDischargeSnapshot{};
        bool startupDiagnosticsEnabled = true;
        std::array<DiagnosticReport, RuntimeConfiguration::MAX_SLAVES> diagnosticReports{};
        size_t diagnosticReportCount = 0U;
        uint16_t diagnosticAttempt = 0U;

        uint8_t currentMeasurementSlaveIdx = 0; // Index of the slave responsible for current measurement
        bool currentMeasurementConfigured = false;
        uint32_t fullSocConditionsSinceMs = 0U;
        bool fullChargeConfirmed = false;
        constexpr uint32_t kSocCalibrationMarker = 0x534F4332U; // "SOC2"
        constexpr uint32_t kSocCalibrationChecksumXor = 0xA56CC39DU;
        constexpr uint32_t kSocCalibrationDetailsMarker = 0x53434431U; // "SCD1"
        constexpr uint32_t kSocCalibrationDetailsCompleteMarker = 0x53434432U; // "SCD2"
        constexpr uint32_t kSocCalibrationDetailsIncompleteMarker = 0x53434433U; // "SCD3"
        constexpr uint8_t kSocCalibrationDetailsBackupRegister = 20U;
        constexpr uint8_t kSocCalibrationSelfDischargeBackupRegister = 26U;
        constexpr uint8_t kSocCalibrationTimeBackupRegister = 28U;

        volatile uint32_t *socCalibrationDetails = &(TAMP->BKP0R) + kSocCalibrationDetailsBackupRegister;
        volatile uint32_t *socCalibrationSelfDischargeLoss =
            &(TAMP->BKP0R) + kSocCalibrationSelfDischargeBackupRegister;
        volatile uint32_t *socCalibrationTime = &(TAMP->BKP0R) + kSocCalibrationTimeBackupRegister;
        volatile uint32_t *socCalibrationChecksum = &(TAMP->BKP0R) + kSocCalibrationTimeBackupRegister + 1U;
        volatile uint32_t *socCalibrationMarker = &(TAMP->BKP0R) + kSocCalibrationTimeBackupRegister + 2U;

        std::atomic<uint32_t> measurementSequence{0};
        bool completeMeasurementSetValid = false;
        std::atomic<bool> publishedMeasurementsFresh{false};
        std::atomic<bool> publishedMeasurementValid{false};
        constexpr TickType_t kMeasurementFrameLockTimeout = pdMS_TO_TICKS(2U);
        StaticSemaphore_t measurementFrameMutexStorage{};
        SemaphoreHandle_t measurementFrameMutex = nullptr;
        MeasurementFrame workingMeasurementFrame{};
        MeasurementFrame latestMeasurementFrame{};
        BatteryCanSnapshot latestBatteryCanSnapshot{};
        BatteryCanSnapshot lastValidBatteryCanSnapshot{};
        bool hasValidBatteryCanSnapshot = false;
        uint8_t consecutiveCommunicationFailures = 0U;
        std::atomic<bool> chargeTemperatureInhibit{false};
        TemperatureLimits::Controller temperatureController;
        TemperatureLimits::Limits temperatureLimits;
        CurrentLimitGuard::Controller currentLimitGuard;
        CurrentLimitGuard::Event currentLimitEvent;
        double publishedChargeCurrentLimitA = 0.0;
        double publishedDischargeCurrentLimitA = 0.0;
        uint32_t currentLimitUpdatedAtMs = 0U;
        bool currentLimitRecoveryInitialized = false;

        bool cellOverVoltageActive = false;
        bool cellUnderVoltageActive = false;
        bool overTemperatureActive = false;
        bool underTemperatureActive = false;
        bool overCurrentActive = false;
        bool communicationFaultActive = false;
        bool internalFaultActive = false;

        uint16_t minICtemperature = UINT16_MAX;
        uint16_t maxICtemperature = 0;
        uint16_t minNTCtemperature = UINT16_MAX;
        uint16_t maxNTCtemperature = 0;
        uint16_t averageNTCtemperature = 0;
        uint32_t NTCtemperatureCount = 0;

        uint32_t minCellVoltage = UINT32_MAX;
        uint32_t maxCellVoltage = 0;
        // Published only after a complete measurement pass. PCC reads this
        // from its own task, so never expose the accumulator while it is
        // being rebuilt cell-by-cell.
        std::atomic<uint32_t> packVoltage{0U};
        double packCurrent = 0.0;

        RegisterRequest registerRequest = {};
        RegisterReponse registerResponse = {};
        bool registerResponseReady = false;
        bool registerRequestBusy = false;

        /*******************************************************************************
         * Private functions
         ******************************************************************************/

        bool disableCellBalancing(bool clearChannelConfiguration);

        void resetBalancingControllerState(bool hardwareKnownDisabled = false)
        {
            activeBalancingMasks.fill(0U);
            balancingSelectionStartIndices.fill(0U);
            balancingHardwareStateKnown = hardwareKnownDisabled;
            balancingCycleActive = false;
            balancingCurrentQualification.reset();
            balancingCycleEndMs = 0U;
            for (auto &timeline : balancingAccountingTimelines) timeline.reset();
        }

        void accumulateBalancingCharge(size_t slaveIndex, uint32_t now)
        {
            if (slaveIndex >= mSlaves.size() || slaveIndex >= workingMeasurementFrame.monitorCount)
            {
                return;
            }
            const uint32_t enabledDurationMs = balancingAccountingTimelines[slaveIndex]
                                                  .takeEnabledMilliseconds(now);
            if (enabledDurationMs == 0U)
            {
                return;
            }

            const auto &monitor = workingMeasurementFrame.monitors[slaveIndex];
            const uint16_t activeMask = activeBalancingMasks[slaveIndex];
            for (size_t cellIndex = 0U;
                 cellIndex < monitor.cellCount && cellIndex < MAX_MEASUREMENT_CELLS;
                 ++cellIndex)
            {
                if ((activeMask & (1U << cellIndex)) == 0U) continue;
                // Keep floating-point work outside the critical section;
                // only protect the small counter copies and update.
                const uint32_t cellVoltageUv = monitor.cellVoltagesUv[cellIndex];
                const uint64_t increment = BalancingCharge::milliAmpMilliseconds(
                    cellVoltageUv, BMS_BAL_RESISTANCE, enabledDurationMs);
                BalancingCharge::Counter updated{};
                taskENTER_CRITICAL();
                updated = balancingChargeMilliAmpMs[slaveIndex][cellIndex];
                taskEXIT_CRITICAL();
                BalancingCharge::addMilliAmpMilliseconds(updated, increment);
                taskENTER_CRITICAL();
                balancingChargeMilliAmpMs[slaveIndex][cellIndex] = updated;
                taskEXIT_CRITICAL();
            }
        }

        double shuntResistanceOhms()
        {
            return runtimeConfiguration.shuntResistanceMicroOhms / 1'000'000.0;
        }

        double batteryCapacityAh()
        {
            return runtimeConfiguration.batteryCapacityMilliAh / 1'000.0;
        }

        uint32_t socCalibrationDetailsChecksum(uint32_t packedSoc, uint32_t unixTime,
                                               uint32_t previousUnixTime, uint32_t dwellMs)
        {
            uint32_t checksum = 2166136261U;
            for (const uint32_t value : {packedSoc, unixTime, previousUnixTime, dwellMs})
            {
                checksum = (checksum ^ value) * 16777619U;
            }
            return checksum;
        }

        uint32_t socCalibrationDetailsChecksum(uint32_t packedSoc, uint32_t unixTime,
                                               uint32_t previousUnixTime, uint32_t dwellMs,
                                               uint32_t modeledLossMilliAh, uint32_t marker)
        {
            uint32_t checksum = socCalibrationDetailsChecksum(packedSoc, unixTime,
                                                              previousUnixTime, dwellMs);
            for (const uint32_t value : {modeledLossMilliAh, marker})
            {
                checksum = (checksum ^ value) * 16777619U;
            }
            return checksum;
        }

        void markSelfDischargeDiagnosticsIncomplete()
        {
            selfDischargeInterval.markIncomplete();
        }

        void publishSelfDischargeSnapshot()
        {
            const bool socValid = currentMeasurementConfigured &&
                                  currentMeasurementSlaveIdx < mSlaves.size() &&
                                  mSlaves[currentMeasurementSlaveIdx].ahCounterIsValid();
            const SelfDischargeSnapshot snapshot = {
                .rateTenthPercentPer30Days = runtimeConfiguration.selfDischargeRateTenthPercentPer30Days,
                .equivalentCurrentMicroAmps = static_cast<uint32_t>(SelfDischarge::equivalentCurrentMicroAmps(
                    runtimeConfiguration.batteryCapacityMilliAh,
                    runtimeConfiguration.selfDischargeRateTenthPercentPer30Days)),
                .accumulatedSinceCalibrationMicroAh = selfDischargeInterval.accumulatedMicroAh(),
                .socValid = socValid,
                .intervalComplete = socValid && selfDischargeInterval.complete(),
            };
            taskENTER_CRITICAL();
            publishedSelfDischargeSnapshot = snapshot;
            taskEXIT_CRITICAL();
        }

        void updateSelfDischarge(uint32_t nowMs)
        {
            const uint32_t elapsedMs = nowMs - selfDischargeLastTickMs;
            selfDischargeLastTickMs = nowMs;
            if (elapsedMs == 0U)
            {
                publishSelfDischargeSnapshot();
                return;
            }

            if (!currentMeasurementConfigured || currentMeasurementSlaveIdx >= mSlaves.size() ||
                !mSlaves[currentMeasurementSlaveIdx].ahCounterIsValid())
            {
                markSelfDischargeDiagnosticsIncomplete();
                publishSelfDischargeSnapshot();
                return;
            }

            const uint64_t lossMicroAh = selfDischargeInterval.advance(
                runtimeConfiguration.batteryCapacityMilliAh,
                runtimeConfiguration.selfDischargeRateTenthPercentPer30Days,
                elapsedMs, true);

            // Apply every whole µAh directly. RTC backup writes have no flash
            // wear, and avoiding a second pending buffer keeps applied charge
            // aligned with the exact fixed-point diagnostic total.
            if (lossMicroAh != 0U)
            {
                const double currentAh = mSlaves[currentMeasurementSlaveIdx].getAhCounter();
                const double lossAh = static_cast<double>(lossMicroAh) / 1'000'000.0;
                const double capacityAh = batteryCapacityAh();
                const double nextAh = std::clamp(currentAh - lossAh, 0.0, capacityAh * 2.0);
                mSlaves[currentMeasurementSlaveIdx].setAhCounter(nextAh);
            }
            publishSelfDischargeSnapshot();
        }

        void beginSelfDischargeCalibrationInterval()
        {
            const bool socValid = currentMeasurementConfigured &&
                                  currentMeasurementSlaveIdx < mSlaves.size() &&
                                  mSlaves[currentMeasurementSlaveIdx].ahCounterIsValid();
            selfDischargeInterval.beginAfterCalibration(socValid);
            publishSelfDischargeSnapshot();
        }

        uint16_t liveSoC()
        {
            if (!currentMeasurementConfigured ||
                currentMeasurementSlaveIdx >= mSlaves.size() ||
                !mSlaves[currentMeasurementSlaveIdx].ahCounterIsValid())
            {
                return BCC_AMPHOUR_TO_SOC(0, batteryCapacityAh());
            }
            const double ampHour = std::clamp(
                mSlaves[currentMeasurementSlaveIdx].getAhCounter(),
                0.0,
                batteryCapacityAh() * 2.0);
            return BCC_AMPHOUR_TO_SOC(ampHour, batteryCapacityAh());
        }

        class MeasurementFrameLock
        {
        public:
            explicit MeasurementFrameLock(TickType_t timeout)
            {
                if (measurementFrameMutex != nullptr)
                {
                    ownsLock = xSemaphoreTake(measurementFrameMutex, timeout) == pdTRUE;
                }
            }

            ~MeasurementFrameLock()
            {
                if (ownsLock) (void)xSemaphoreGive(measurementFrameMutex);
            }

            [[nodiscard]] bool acquired() const
            {
                return ownsLock;
            }

            MeasurementFrameLock(const MeasurementFrameLock &) = delete;
            MeasurementFrameLock &operator=(const MeasurementFrameLock &) = delete;

        private:
            bool ownsLock = false;
        };

        bool measurementsAreFresh()
        {
            if (!completeMeasurementSetValid)
            {
                return false;
            }

            for (auto &slave : mSlaves)
            {
                if ((millis() - slave.getTimeReceivedLastMeasurement()) > settings.SAFETY_LIMITS.COMMUNICATION_TIMEOUT)
                {
                    return false;
                }
            }
            return true;
        }

        void invalidateBatteryCanSnapshot()
        {
            if (measurementFrameMutex == nullptr)
            {
                latestMeasurementFrame.summary = {};
                latestMeasurementFrame.monitorCount = 0U;
            }
            else
            {
                MeasurementFrameLock lock(kMeasurementFrameLockTimeout);
                if (lock.acquired())
                {
                    latestMeasurementFrame.summary = {};
                    latestMeasurementFrame.monitorCount = 0U;
                }
            }
            publishedMeasurementsFresh.store(false, std::memory_order_release);
            publishedMeasurementValid.store(false, std::memory_order_release);
            taskENTER_CRITICAL();
            latestBatteryCanSnapshot = {};
            lastValidBatteryCanSnapshot = {};
            taskEXIT_CRITICAL();
            hasValidBatteryCanSnapshot = false;
            consecutiveCommunicationFailures = 0U;
            publishedChargeCurrentLimitA = 0.0;
            publishedDischargeCurrentLimitA = 0.0;
            currentLimitUpdatedAtMs = 0U;
            currentLimitRecoveryInitialized = false;
            temperatureController.reset();
            temperatureLimits = {};
            currentLimitGuard.reset();
        }

        void updateFullSocCalibration(const double current)
        {
            if (fullChargeConfirmed &&
                (!currentMeasurementConfigured ||
                 currentMeasurementSlaveIdx >= mSlaves.size() ||
                 !mSlaves[currentMeasurementSlaveIdx].ahCounterIsValid() ||
                 mSlaves[currentMeasurementSlaveIdx].getAhCounter() < batteryCapacityAh() * 0.995))
            {
                fullChargeConfirmed = false;
                fullSocConditionsSinceMs = 0U;
            }
            const FaultManager::Snapshot faults = FaultManager::getSnapshot();
            const bool conditionsMet = currentMeasurementConfigured &&
                                       settings.AUTO_CALIBRATE_SOC &&
                                       completeMeasurementSetValid &&
                                       minCellVoltage >= static_cast<uint32_t>(settings.SOC_FULL_CALIBRATION_CELL_VOLTAGE * 1'000'000.0) &&
                                       current >= settings.SOC_FULL_CALIBRATION_MIN_CURRENT &&
                                       current <= batteryCapacityAh() * settings.SOC_FULL_CALIBRATION_MAX_CURRENT_C &&
                                       faults.bmsActive == 0U;
            if (!conditionsMet)
            {
                fullSocConditionsSinceMs = 0U;
                return;
            }

            const uint32_t now = millis();
            if (fullSocConditionsSinceMs == 0U)
            {
                fullSocConditionsSinceMs = now;
                return;
            }

            if (!fullChargeConfirmed && now - fullSocConditionsSinceMs >= settings.SOC_FULL_CALIBRATION_DWELL_MS)
            {
                uint32_t previousUnixTime = 0U;
                (void)getLastSoCCalibrationUnixTime(previousUnixTime);
                HAL_PWR_EnableBkUpAccess();
                // An interrupted calibration must not leave an older detail
                // record paired with a newer counter or timestamp.
                socCalibrationDetails[5] = 0U;
                updateSelfDischarge(millis());
                const bool preSocValid = mSlaves[currentMeasurementSlaveIdx].ahCounterIsValid();
                const uint16_t preSocRaw = preSocValid ? liveSoC() : 0U;
                bool modeledLossComplete = preSocValid && selfDischargeInterval.complete();
                const uint64_t roundedModeledLossMilliAh = SelfDischarge::roundedMilliAmpHours(
                    selfDischargeInterval.accumulatedMicroAh());
                const uint32_t modeledLossMilliAh = static_cast<uint32_t>(std::min<uint64_t>(
                    roundedModeledLossMilliAh, std::numeric_limits<uint32_t>::max()));
                if (roundedModeledLossMilliAh > std::numeric_limits<uint32_t>::max())
                {
                    modeledLossComplete = false;
                }
                setSoC(BCC_SOC_TO_SOCRAW(1));
                selfDischargeLastTickMs = millis();
                fullChargeConfirmed = true;
                // A calibration without valid UTC must not leave an older
                // timestamp behind and imply a false SoC accuracy age.
                *socCalibrationMarker = 0U;
                uint32_t unixTime = 0U;
                if (RtcTime::getUnixTime(unixTime))
                {
                    *socCalibrationTime = unixTime;
                    *socCalibrationChecksum = unixTime ^ kSocCalibrationChecksumXor;
                    __DMB();
                    *socCalibrationMarker = kSocCalibrationMarker;
                    PRINTF_INFO("[SC] SoC calibrated to full charge at %lu UTC\n", static_cast<unsigned long>(unixTime));
                }
                else
                {
                    PRINTF_WARN("[SC] SoC calibrated to full charge before UTC was available\n");
                }
                const uint32_t packedSoc = static_cast<uint32_t>(preSocRaw) |
                                           (preSocValid ? (1UL << 16U) : 0U);
                const uint32_t dwellMs = now - fullSocConditionsSinceMs;
                socCalibrationDetails[0] = packedSoc;
                socCalibrationDetails[1] = unixTime;
                socCalibrationDetails[2] = previousUnixTime;
                socCalibrationDetails[3] = dwellMs;
                *socCalibrationSelfDischargeLoss = modeledLossMilliAh;
                const uint32_t detailsMarker = modeledLossComplete
                                                   ? kSocCalibrationDetailsCompleteMarker
                                                   : kSocCalibrationDetailsIncompleteMarker;
                socCalibrationDetails[4] = socCalibrationDetailsChecksum(
                    packedSoc, unixTime, previousUnixTime, dwellMs,
                    modeledLossMilliAh, detailsMarker);
                __DMB();
                socCalibrationDetails[5] = detailsMarker;
                beginSelfDischargeCalibrationInterval();
            }
        }

        void setState(BMSState state)
        {
            if (state != RUNNING)
            {
                // Do not wait for another RUN-loop iteration to turn the
                // balancing MOSFETs off. The hardware timer remains the final
                // fallback if communication with a BCC has already failed.
                (void)disableCellBalancing(false);
                completeMeasurementSetValid = false;
                invalidateBatteryCanSnapshot();
            }
            currentState = state;
            switch (state)
            {
            case DEVICE_INITIALIZATION:
                PRINTF_INFO("[SC] New state: DEVICE_INITIALIZATION\n");
                break;
            case REGISTER_INITIALIZATION:
                PRINTF_INFO("[SC] New state: REGISTER_INITIALIZATION\n");
                break;
            case PERFORMING_DIAGNOSTICS:
                PRINTF_INFO("[SC] New state: PERFORMING_DIAGNOSTICS\n");
                break;
            case RUNNING:
                PRINTF_INFO("[SC] New state: RUNNING\n");
                break;
            case CRITICAL:
                PRINTF_INFO("[SC] New state: CRITICAL\n");
                break;
            }
        }

        FaultManager::BmsFault mapFault(BMSFault fault)
        {
            switch (fault)
            {
            case INVALID_CONFIG:
                return FaultManager::BmsFault::ConfigurationInvalid;
            case TPL_FAULT:
            case CID_INITIALIZATION_FAULT:
            case REGISTER_INITIALIZATION_FAULT:
                return FaultManager::BmsFault::SlaveUnavailable;
            case CELL_BALANCING_FAULT:
                return FaultManager::BmsFault::BalancingHardwareFault;
            case DIAGNOSTICS_FAULT:
                return FaultManager::BmsFault::BccDiagnostics;
            case OVERVOLTAGE_LIMIT:
            case UNDERVOLTAGE_LIMIT:
                return FaultManager::BmsFault::CellVoltageLimit;
            case TEMPERATURE_LIMIT:
            case IC_TEMPERATURE:
                return FaultManager::BmsFault::ThermalLimit;
            case OVERCURRENT_LIMIT:
                return FaultManager::BmsFault::CurrentLimit;
            case OPEN_SHORT_FAULT:
            case SYSTEM_FAULT:
                return FaultManager::BmsFault::BccIntegrity;
            case COMMUNICATION_TIMEOUT:
                return FaultManager::BmsFault::BccCommunication;
            case NO_CONFIG:
                return FaultManager::BmsFault::NoConfig;
            }
            return FaultManager::BmsFault::BccIntegrity;
        }

        void updateFault(BMSFault fault, bool active)
        {
            bmsFaultInputs[static_cast<size_t>(fault)] = active;
            const FaultManager::BmsFault mappedFault = mapFault(fault);

            bool mappedActive = false;
            for (size_t index = 0U; index < bmsFaultInputs.size(); ++index)
            {
                if (bmsFaultInputs[index] &&
                    mapFault(static_cast<BMSFault>(index)) == mappedFault)
                {
                    mappedActive = true;
                    break;
                }
            }
            FaultManager::setBmsFault(mappedFault, mappedActive);
        }

        // Checks if all CIDs are present
        bool allCIDsPresence()
        {
            // Loop over slaves
            for (auto &slave : mSlaves)
            {
                // Check if the CID is present
                if (!slave.isPresent())
                {
                    PRINTF_ERR("[SC] Cannot communicate with CID %d\n", slave.getCID());
                    return false;
                }
            }
            return true;
        }

        vector<bcc_init_reg_t> getInitGlobalRegisterMapping()
        {

            uint16_t ov_limit_mv = settings.SAFETY_LIMITS.OVERVOLTAGE_LIMIT * 1000;
            uint16_t uv_limit_mv = settings.SAFETY_LIMITS.UNDERVOLTAGE_LIMIT * 1000;

            uint16_t ot_an_reg_val = BCC_TEMP_TO_VOLT(settings.SAFETY_LIMITS.OVERTEMPERATURE_LIMIT, settings.NTC_RESISTANCE, settings.NTC_BETA);
            uint16_t ut_an_reg_val = BCC_TEMP_TO_VOLT(settings.SAFETY_LIMITS.UNDERTEMPERATURE_LIMIT, settings.NTC_RESISTANCE, settings.NTC_BETA);

            return {
                {MC33771C_GPIO_CFG1_OFFSET, MC33771C_GPIO_CFG1_POR_VAL, MC33771C_GPIO_CFG1_VALUE},
                {MC33771C_GPIO_CFG2_OFFSET, MC33771C_GPIO_CFG2_POR_VAL, MC33771C_GPIO_CFG2_VALUE},
                {MC33771C_TH_ALL_CT_OFFSET, MC33771C_TH_ALL_CT_POR_VAL, (uint16_t)MC33771C_TH_ALL_CT_VALUE(ov_limit_mv, uv_limit_mv)},
                {MC33771C_TH_AN6_OT_OFFSET, MC33771C_TH_AN6_OT_POR_VAL, (uint16_t)MC33771C_TH_ANX_OT_VALUE(ot_an_reg_val)},
                {MC33771C_TH_AN5_OT_OFFSET, MC33771C_TH_AN5_OT_POR_VAL, (uint16_t)MC33771C_TH_ANX_OT_VALUE(ot_an_reg_val)},
                {MC33771C_TH_AN4_OT_OFFSET, MC33771C_TH_AN4_OT_POR_VAL, (uint16_t)MC33771C_TH_ANX_OT_VALUE(ot_an_reg_val)},
                {MC33771C_TH_AN3_OT_OFFSET, MC33771C_TH_AN3_OT_POR_VAL, (uint16_t)MC33771C_TH_ANX_OT_VALUE(ot_an_reg_val)},
                {MC33771C_TH_AN2_OT_OFFSET, MC33771C_TH_AN2_OT_POR_VAL, (uint16_t)MC33771C_TH_ANX_OT_VALUE(ot_an_reg_val)},
                {MC33771C_TH_AN1_OT_OFFSET, MC33771C_TH_AN1_OT_POR_VAL, (uint16_t)MC33771C_TH_ANX_OT_VALUE(ot_an_reg_val)},
                {MC33771C_TH_AN0_OT_OFFSET, MC33771C_TH_AN0_OT_POR_VAL, (uint16_t)MC33771C_TH_ANX_OT_VALUE(ot_an_reg_val)},
                {MC33771C_TH_AN6_UT_OFFSET, MC33771C_TH_AN6_UT_POR_VAL, (uint16_t)MC33771C_TH_ANX_UT_VALUE(ut_an_reg_val)},
                {MC33771C_TH_AN5_UT_OFFSET, MC33771C_TH_AN5_UT_POR_VAL, (uint16_t)MC33771C_TH_ANX_UT_VALUE(ut_an_reg_val)},
                {MC33771C_TH_AN4_UT_OFFSET, MC33771C_TH_AN4_UT_POR_VAL, (uint16_t)MC33771C_TH_ANX_UT_VALUE(ut_an_reg_val)},
                {MC33771C_TH_AN3_UT_OFFSET, MC33771C_TH_AN3_UT_POR_VAL, (uint16_t)MC33771C_TH_ANX_UT_VALUE(ut_an_reg_val)},
                {MC33771C_TH_AN2_UT_OFFSET, MC33771C_TH_AN2_UT_POR_VAL, (uint16_t)MC33771C_TH_ANX_UT_VALUE(ut_an_reg_val)},
                {MC33771C_TH_AN1_UT_OFFSET, MC33771C_TH_AN1_UT_POR_VAL, (uint16_t)MC33771C_TH_ANX_UT_VALUE(ut_an_reg_val)},
                {MC33771C_TH_AN0_UT_OFFSET, MC33771C_TH_AN0_UT_POR_VAL, (uint16_t)MC33771C_TH_ANX_UT_VALUE(ut_an_reg_val)},
                {MC33771C_SYS_CFG1_OFFSET, MC33771C_SYS_CFG1_POR_VAL, MC33771C_SYS_CFG1_VALUE(false)}, // Per-slave measurement-circuit policy is applied below.
                {MC33771C_SYS_CFG2_OFFSET, MC33771C_SYS_CFG2_POR_VAL, MC33771C_SYS_CFG2_VALUE},
                {MC33771C_ADC_CFG_OFFSET, MC33771C_ADC_CFG_POR_VAL, MC33771C_ADC_CFG_VALUE},
                {MC33771C_ADC2_OFFSET_COMP_OFFSET, MC33771C_ADC2_OFFSET_COMP_POR_VAL, MC33771C_ADC2_OFFSET_COMP_VALUE}, // Only useful if I_MEAS is enabled, but global write is probably fine
                {MC33771C_FAULT_MASK1_OFFSET, MC33771C_FAULT_MASK1_POR_VAL, MC33771C_FAULT_MASK1_VALUE},
                {MC33771C_FAULT_MASK2_OFFSET, MC33771C_FAULT_MASK2_POR_VAL, MC33771C_FAULT_MASK2_VALUE},
                {MC33771C_FAULT_MASK3_OFFSET, MC33771C_FAULT_MASK3_POR_VAL, MC33771C_FAULT_MASK3_VALUE},
            };
        }

        /*! @brief This function initializes registers of all devices in the TPL chain.
         *  Based on the example in the programming guide.
         *
         * @return bool True if the initialization was successful, false otherwise.
         */
        bool initializeRegisters()
        {
            for (auto &slave : mSlaves) slave.resetCurrentBaseline();
            bcc_status_t status;

            vector<bcc_init_reg_t> globalRegisters = getInitGlobalRegisterMapping();

            // Write global registers
            for (uint16_t i = 0; i < globalRegisters.size(); i++)
            {
                if (globalRegisters[i].value != globalRegisters[i].defaultVal)
                {
                    if ((status = BCC::regWriteGlobal(globalRegisters[i].address, globalRegisters[i].value)) != BCC_STATUS_SUCCESS)
                    {
                        // TODO this: reportBCCError(status, 0);
                        return false;
                    }
                }
            }

            // Loop trough all devices to set slave specific registers based on config
            for (auto &slave : mSlaves)
            {
                // Hardware power policy is separate from the authoritative
                // shunt/SoC role. Explicitly write both enabled and disabled
                // states on every initialization, then verify the enable bit.
                const bool circuitEnabled = CurrentSensingPolicy::measurementCircuitEnabled(
                    currentMeasurementConfigured, slave.currentSenseEnabled(), EQUALIZE_CURRENT_MEASUREMENT_LOAD);
                if ((status = slave.regWrite(MC33771C_SYS_CFG1_OFFSET, MC33771C_SYS_CFG1_VALUE(circuitEnabled))) != BCC_STATUS_SUCCESS)
                {
                    return false;
                }
                uint16_t sysCfg1 = 0U;
                if (slave.regRead(MC33771C_SYS_CFG1_OFFSET, 1U, &sysCfg1) != BCC_STATUS_SUCCESS ||
                    ((sysCfg1 & MC33771C_SYS_CFG1_I_MEAS_EN_MASK) != 0U) != circuitEnabled)
                {
                    return false;
                }

                // Depending on number of NTCs used, set unused GPIOs to digital in, (and highest bits to 0)
                uint16_t regValue = (0x2AAA << 2 * slave.getNTCCount()) & 0x3FFF;
                if ((status = slave.regWrite(MC33771C_GPIO_CFG1_OFFSET, regValue)) != BCC_STATUS_SUCCESS)
                {
                    return false;
                }

                // Disable OV/UV detection for unused cells  (reg OV_UV_EN)
                regValue = slave.getCellMap();

                // Set Common OV/UV threshold bits
                regValue |= 0xC000U;

                if ((status = slave.regWrite(MC33771C_OV_UV_EN_OFFSET, regValue)) != BCC_STATUS_SUCCESS)
                {
                    return false;
                }
            }

            // CBx_CFG survives a CB_DRVEN disable, so explicitly establish an
            // empty channel selection after every register initialization.
            for (auto &slave : mSlaves)
            {
                if (slave.CB_Enable(false) != BCC_STATUS_SUCCESS ||
                    slave.CB_ClearAllChannels() != BCC_STATUS_SUCCESS)
                {
                    return false;
                }
            }

            // Clear fault bits
            if ((status = BCC::regWriteGlobal(MC33771C_CELL_OV_FLT_OFFSET, 0x0000U)) != BCC_STATUS_SUCCESS ||
                (status = BCC::regWriteGlobal(MC33771C_CELL_UV_FLT_OFFSET, 0x0000U)) != BCC_STATUS_SUCCESS ||
                (status = BCC::regWriteGlobal(MC33771C_AN_OT_UT_FLT_OFFSET, 0x0000U)) != BCC_STATUS_SUCCESS ||
                (status = BCC::regWriteGlobal(MC33771C_FAULT1_STATUS_OFFSET, 0x0000U)) != BCC_STATUS_SUCCESS ||
                (status = BCC::regWriteGlobal(MC33771C_FAULT2_STATUS_OFFSET, 0x0000U)) != BCC_STATUS_SUCCESS ||
                (status = BCC::regWriteGlobal(MC33771C_FAULT3_STATUS_OFFSET, 0x0000U)) != BCC_STATUS_SUCCESS)
            {
                // TODO this: reportBCCError(status, 0);
                return false;
            }

            // SYS_CFG1 and CBx_CFG now contain known disabled values.
            resetBalancingControllerState(true);
            return true;
        };

        bool startMeasurements()
        {
            // Pause CB for all slaves
            for (size_t slaveIndex = 0U; slaveIndex < mSlaves.size(); ++slaveIndex)
            {
                accumulateBalancingCharge(slaveIndex, millis());
                auto &slave = mSlaves[slaveIndex];
                if (slave.CB_Pause(true) != BCC_STATUS_SUCCESS)
                {
                    PRINTF_WARN("[SC] Slave (CID: %u) failed on: pause balancing\n", slave.getCID());
                    for (size_t index = 0U; index < mSlaves.size(); ++index)
                    {
                        (void)mSlaves[index].CB_Pause(false);
                        balancingAccountingTimelines[index].invalidate(millis());
                    }
                    return false;
                }
                balancingAccountingTimelines[slaveIndex].pause(millis());
            }

            // It is recommended to wait for at least 3ms before starting the ADC conversion
            // to ensure that the LP filters have settled.
            delay(3);

            if (BCC::meas_StartConversionGlobal() != BCC_STATUS_SUCCESS)
            {
                bool resumed = true;
                for (size_t slaveIndex = 0U; slaveIndex < mSlaves.size(); ++slaveIndex)
                {
                    const bool success = mSlaves[slaveIndex].CB_Pause(false) == BCC_STATUS_SUCCESS;
                    resumed = success && resumed;
                    if (success) balancingAccountingTimelines[slaveIndex].resume(millis());
                    else balancingAccountingTimelines[slaveIndex].invalidate(millis());
                }
                if (!resumed)
                {
                    for (auto &timeline : balancingAccountingTimelines) timeline.invalidate(millis());
                }
                return false;
            }

            // Wait for the conversion to finish
            for (auto &slave : mSlaves)
            {
                if (slave.meas_WaitOnConversion(BCC_ADC_AVG) != BCC_STATUS_SUCCESS)
                {
                    PRINTF_WARN("[SC] Slave (CID: %u) failed on: wait on conversion\n", slave.getCID());
                    bool resumed = true;
                    for (size_t index = 0U; index < mSlaves.size(); ++index)
                    {
                        const bool success = mSlaves[index].CB_Pause(false) == BCC_STATUS_SUCCESS;
                        resumed = success && resumed;
                        if (success) balancingAccountingTimelines[index].resume(millis());
                        else balancingAccountingTimelines[index].invalidate(millis());
                    }
                    if (!resumed)
                    {
                        for (auto &timeline : balancingAccountingTimelines) timeline.invalidate(millis());
                    }
                    return false;
                }
            }

            // Resume CB
            for (size_t slaveIndex = 0U; slaveIndex < mSlaves.size(); ++slaveIndex)
            {
                auto &slave = mSlaves[slaveIndex];
                if (slave.CB_Pause(false) != BCC_STATUS_SUCCESS)
                {
                    PRINTF_WARN("[SC] Slave (CID: %u) failed on: resume balancing\n", slave.getCID());
                    for (auto &timeline : balancingAccountingTimelines) timeline.invalidate(millis());
                    return false;
                }
                balancingAccountingTimelines[slaveIndex].resume(millis());
            }

            return true;
        };

        bool faultDetection()
        {
            uint16_t combinedFaults[BCC_STAT_CNT] = {0};
            for (auto &slave : mSlaves)
            {
                if (slave.fault_GetStatus(combinedFaults) != BCC_STATUS_SUCCESS)
                {
                    PRINTF_WARN("[SC] Slave (CID: %u) failed on: get fault status\n", slave.getCID());
                    return false;
                }

                // TODO Log all fault registers in FLASH or something
            }

            if (currentMeasurementConfigured)
            {
                double ampHour = 0.0;
                double current = 0.0;
                if (mSlaves[currentMeasurementSlaveIdx].meas_GetAmpHourAndIAvg(
                        shuntResistanceOhms(),
                        runtimeConfiguration.invertCurrent,
                        batteryCapacityAh(),
                        &ampHour,
                        &current, true) != BCC_STATUS_SUCCESS)
                {
                    PRINTF_WARN("[SC] Current measurement failed on CID %u\n",
                                mSlaves[currentMeasurementSlaveIdx].getCID());
                    return false;
                }
                else
                {
                    packCurrent = current;
                    overCurrentActive = current < -settings.SAFETY_LIMITS.DISCHARGE_CURRENT_LIMIT ||
                                        current > settings.SAFETY_LIMITS.CHARGE_CURRENT_LIMIT;
                    updateFault(OVERCURRENT_LIMIT, overCurrentActive);
                }
            }
            else
            {
                packCurrent = 0.0;
                overCurrentActive = false;
                updateFault(OVERCURRENT_LIMIT, false);
            }

            cellOverVoltageActive = combinedFaults[BCC_FS_CELL_OV] != 0;
            cellUnderVoltageActive = combinedFaults[BCC_FS_CELL_UV] != 0;
            const uint16_t temperatureFaults = combinedFaults[BCC_FS_AN_OT_UT];
            temperatureLimits = temperatureController.update(
                completeMeasurementSetValid && measurementsAreFresh() && NTCtemperatureCount != 0U,
                BCC_TEMPRAW_TO_TEMP(minNTCtemperature), BCC_TEMPRAW_TO_TEMP(maxNTCtemperature),
                runtimeConfiguration.coldAllowanceDeciC / 10.0, batteryCapacityAh());
            underTemperatureActive = temperatureLimits.coldStopped;
            overTemperatureActive = (temperatureFaults & 0x7F00U) != 0U;
            chargeTemperatureInhibit.store(underTemperatureActive || temperatureLimits.hotStopped, std::memory_order_relaxed);

            updateFault(OVERVOLTAGE_LIMIT, cellOverVoltageActive);
            updateFault(UNDERVOLTAGE_LIMIT, cellUnderVoltageActive);
            /* Low temperature is deliberately directional: it inhibits charge
             * but does not make the pack unavailable for discharge. */
            updateFault(TEMPERATURE_LIMIT, overTemperatureActive);

            const bool openShortFault = combinedFaults[BCC_FS_CB_OPEN] != 0 ||
                                        combinedFaults[BCC_FS_CB_SHORT] != 0 ||
                                        combinedFaults[BCC_FS_GPIO_SHORT] != 0;
            const bool icTemperatureFault =
                (combinedFaults[BCC_FS_FAULT2] & MC33771C_FAULT2_STATUS_IC_TSD_FLT_MASK) != 0;
            const bool systemFault = combinedFaults[BCC_FS_FAULT1] != 0 ||
                                     (combinedFaults[BCC_FS_FAULT2] &
                                      ~MC33771C_FAULT2_STATUS_IC_TSD_FLT_MASK) != 0 ||
                                     combinedFaults[BCC_FS_FAULT3] != 0;
            internalFaultActive = openShortFault || icTemperatureFault || systemFault;
            updateFault(OPEN_SHORT_FAULT, openShortFault);
            updateFault(IC_TEMPERATURE, icTemperatureFault);
            updateFault(SYSTEM_FAULT, systemFault);
            if (currentMeasurementConfigured)
            {
                updateFullSocCalibration(packCurrent);
            }
            return true;
        };

        bool getMeasurements(bool forceRead = false)
        {
            bcc_status_t status;
            static uint32_t loopCount = 0;

            // Only fetch measurements every x loops
            // Once a measurement pass has failed, the next communication
            // attempt must perform a real read; otherwise the period divider
            // would keep returning the previous invalid state and consume all
            // three retries without testing recovery.
            if (!forceRead && completeMeasurementSetValid &&
                (loopCount++ % settings.BMS_MEASUREMENT_PERIOD_FACTOR) != 0)
            {
                return true;
            }

            // PRINTF_INFO("[SC] Fetching measurements\n");
            for (auto &slave : mSlaves)
            {
                // Fetch the measurements from the BCC
                if ((status = slave.meas_GetRawValues()) != BCC_STATUS_SUCCESS)
                {
                    PRINTF_WARN("[SC] Slave (CID: %u) failed on: get raw values\n", slave.getCID());
                    return false;
                }
            }

            // Reset stats
            minCellVoltage = UINT32_MAX;
            maxCellVoltage = 0;
            minNTCtemperature = UINT16_MAX;
            maxNTCtemperature = 0;
            averageNTCtemperature = 0;
            NTCtemperatureCount = 0;
            uint32_t ntcTemperatureSum = 0U;
            minICtemperature = UINT16_MAX;
            maxICtemperature = 0;
            uint32_t measuredPackVoltage = 0U;

            // Gather all cell voltages & temperatures and put them into static 2D arrays
            for (size_t i = 0; i < getNumOfSlaves(); i++)
            {
                MonitorMeasurements &monitor = workingMeasurementFrame.monitors[i];
                monitor.cellCount = mSlaves[i].getCellCount();
                monitor.ntcCount = mSlaves[i].getNTCCount();

                // Get the cell voltages
                if (mSlaves[i].meas_GetCellVoltages(
                        std::span<uint32_t>(monitor.cellVoltagesUv.data(), monitor.cellCount)) != BCC_STATUS_SUCCESS)
                {
                    PRINTF_WARN("[SC] Slave (CID: %u) failed on: get cell voltages\n", mSlaves[i].getCID());
                    return false;
                }

                // Get the NTC temperatures
                if (mSlaves[i].meas_GetNTCTemperatures(
                        std::span<uint16_t>(monitor.ntcTemperaturesRaw.data(), monitor.ntcCount),
                        settings.NTC_RESISTANCE,
                        settings.NTC_BETA) != BCC_STATUS_SUCCESS)
                {
                    PRINTF_WARN("[SC] Slave (CID: %u) failed on: get NTC temperatures\n", mSlaves[i].getCID());
                    return false;
                }

                // Also get the IC temperature
                if (mSlaves[i].meas_GetIcTemperature(&monitor.icTemperatureRaw) != BCC_STATUS_SUCCESS)
                {
                    PRINTF_WARN("[SC] Slave (CID: %u) failed on: get IC temperature\n", mSlaves[i].getCID());
                    return false;
                }

                // Update some cell voltage stats
                for (size_t cellIndex = 0U; cellIndex < mSlaves[i].getCellCount(); ++cellIndex)
                {
                    const uint32_t cellVoltage = monitor.cellVoltagesUv[cellIndex];
                    if (cellVoltage < minCellVoltage)
                    {
                        minCellVoltage = cellVoltage;
                    }
                    if (cellVoltage > maxCellVoltage)
                    {
                        maxCellVoltage = cellVoltage;
                    }
                    measuredPackVoltage += cellVoltage;
                }

                // Update some NTC temperature stats
                for (size_t ntcIndex = 0U; ntcIndex < mSlaves[i].getNTCCount(); ++ntcIndex)
                {
                    const uint16_t NTCtemperature = monitor.ntcTemperaturesRaw[ntcIndex];
                    ntcTemperatureSum += NTCtemperature;
                    NTCtemperatureCount++;
                    if (NTCtemperature < minNTCtemperature)
                    {
                        minNTCtemperature = NTCtemperature;
                    }
                    if (NTCtemperature > maxNTCtemperature)
                    {
                        maxNTCtemperature = NTCtemperature;
                    }
                }

                // Update IC temperature stats
                if (monitor.icTemperatureRaw > maxICtemperature)
                {
                    maxICtemperature = monitor.icTemperatureRaw;
                }
                if (monitor.icTemperatureRaw < minICtemperature)
                {
                    minICtemperature = monitor.icTemperatureRaw;
                }
            }

            averageNTCtemperature = NTCtemperatureCount == 0U
                                        ? 0U
                                        : static_cast<uint16_t>(ntcTemperatureSum / NTCtemperatureCount);

            packVoltage.store(measuredPackVoltage, std::memory_order_release);

            completeMeasurementSetValid = true;
            return true;
        }

        bool doCommunicationCheck(bool faultStatusSuccessful)
        {
            bool communicationFault = !measurementsAreFresh() || !faultStatusSuccessful;

            if (!communicationFault && !allCIDsPresence())
            {
                communicationFault = true;
            }

            if (!communicationFault)
            {
                consecutiveCommunicationFailures = 0U;
                communicationFaultActive = false;
                FaultManager::setWarning(FaultManager::Warning::BccCommunicationRetry, false);
                updateFault(COMMUNICATION_TIMEOUT, false);
                return false;
            }

            if (consecutiveCommunicationFailures < kCommunicationFailureTripCount)
            {
                ++consecutiveCommunicationFailures;
            }
            communicationFaultActive = true;

            if (consecutiveCommunicationFailures < kCommunicationFailureTripCount)
            {
                FaultManager::setWarning(FaultManager::Warning::BccCommunicationRetry, true);
                // A transient communication loss is not yet a BMS fault.
                updateFault(COMMUNICATION_TIMEOUT, false);
                PRINTF_WARN("[SC] BCC communication retry %u/%u\n",
                            consecutiveCommunicationFailures,
                            kCommunicationFailureTripCount);
                return false;
            }

            FaultManager::setWarning(FaultManager::Warning::BccCommunicationRetry, false);
            updateFault(COMMUNICATION_TIMEOUT, true);
            PRINTF_ERR("[SC] BCC communication failed %u consecutive times\n",
                       kCommunicationFailureTripCount);
            return true;
        }

        void publishHeldBatteryCanSnapshot()
        {
            // Telemetry is stale, but the inverter-facing command remains the
            // last valid one until the retry threshold trips.  The snapshot
            // remains valid so GoodWe CAN continues transmitting the retained
            // current limits and the communication warning.
            publishedMeasurementsFresh.store(false, std::memory_order_release);
            if (!hasValidBatteryCanSnapshot)
            {
                return;
            }

            BatteryCanSnapshot snapshot = lastValidBatteryCanSnapshot;
            snapshot.measurementsFresh = false;
            snapshot.communicationFault = true;

            // Known higher-level safety changes still override the retained
            // BCC values immediately.
            const bool hvConnected = PCC::getPCCState() == PCC::RUN;
            const bool commonSafeNow = currentState == RUNNING &&
                                       hvConnected &&
                                       FaultManager::canEnableHv();
            snapshot.commonSafe = snapshot.commonSafe && commonSafeNow;
            snapshot.chargeAllowed = snapshot.chargeAllowed &&
                                     snapshot.commonSafe &&
                                     !chargeTemperatureInhibit.load(std::memory_order_relaxed);
            snapshot.dischargeAllowed = snapshot.dischargeAllowed && snapshot.commonSafe && !temperatureLimits.hotStopped;
            if (!snapshot.chargeAllowed)
            {
                snapshot.chargeCurrentA = 0.0;
            }
            if (!snapshot.dischargeAllowed)
            {
                snapshot.dischargeCurrentA = 0.0;
            }

            taskENTER_CRITICAL();
            latestBatteryCanSnapshot = snapshot;
            taskEXIT_CRITICAL();
        }

        void publishBatteryCanSnapshot(uint32_t publishedSequence)
        {
            BatteryCanSnapshot snapshot{};
            MeasurementFrame &measurement = workingMeasurementFrame;
            measurement.summary = {};
            measurement.monitorCount = static_cast<uint8_t>(mSlaves.size());
            MeasurementSummary &summary = measurement.summary;

            snapshot.measurementsFresh = measurementsAreFresh();
            snapshot.socValid = currentMeasurementConfigured &&
                                currentMeasurementSlaveIdx < mSlaves.size() &&
                                mSlaves[currentMeasurementSlaveIdx].ahCounterIsValid();
            snapshot.currentSensingEnabled = currentMeasurementConfigured;
            snapshot.valid = currentState == RUNNING &&
                             completeMeasurementSetValid &&
                             snapshot.measurementsFresh &&
                             NTCtemperatureCount != 0U;

            // BMS health alone must not advertise usable charge/discharge
            // current to the inverter.  Keep publishing the battery limits
            // and status while the contactor is open, but make the effective
            // current limits zero until the HV path is actually in RUN.
            const bool hvConnected = PCC::getPCCState() == PCC::RUN;
            snapshot.commonSafe = currentState == RUNNING &&
                                  hvConnected &&
                                  FaultManager::canEnableHv() &&
                                  snapshot.measurementsFresh;
            snapshot.chargeAllowed = snapshot.commonSafe &&
                                     !chargeTemperatureInhibit.load(std::memory_order_relaxed);
            snapshot.dischargeAllowed = snapshot.commonSafe && !temperatureLimits.hotStopped;

            snapshot.cellOverVoltage = cellOverVoltageActive;
            snapshot.cellUnderVoltage = cellUnderVoltageActive;
            snapshot.overTemperature = overTemperatureActive || temperatureLimits.hotStopped;
            snapshot.underTemperature = underTemperatureActive;
            snapshot.overCurrent = overCurrentActive;
            snapshot.communicationFault = communicationFaultActive;
            snapshot.internalFault = internalFaultActive;

            snapshot.packVoltageUv = packVoltage.load(std::memory_order_acquire);
            snapshot.packCurrentA = packCurrent;
            const uint16_t cellCount = getCellCount();
            const BatteryLimits::Config inverterLimits{
                .chargeDeratingStartCellV = settings.INVERTER_LIMITS.CHARGE_DERATING_START_CELL_VOLTAGE,
                .chargeTargetCellV = settings.INVERTER_LIMITS.CHARGE_TARGET_CELL_VOLTAGE,
                .dischargeTargetCellV = settings.INVERTER_LIMITS.DISCHARGE_TARGET_CELL_VOLTAGE,
                .dischargeStopCellV = settings.INVERTER_LIMITS.DISCHARGE_STOP_CELL_VOLTAGE,
                .recoveryFractionPerSecond = settings.INVERTER_LIMITS.CURRENT_LIMIT_RECOVERY_RATE,
            };
            const BatteryLimits::Limits requestedLimits = BatteryLimits::calculate(
                inverterLimits,
                cellCount,
                minCellVoltage / 1'000'000.0,
                maxCellVoltage / 1'000'000.0,
                settings.SAFETY_LIMITS.CHARGE_CURRENT_LIMIT,
                settings.SAFETY_LIMITS.DISCHARGE_CURRENT_LIMIT);

            const uint32_t now = millis();
            const uint32_t elapsedMs = currentLimitRecoveryInitialized
                                           ? now - currentLimitUpdatedAtMs
                                           : 0U;
            currentLimitUpdatedAtMs = now;
            currentLimitRecoveryInitialized = true;

            const double requestedChargeCurrentA = snapshot.valid && snapshot.chargeAllowed
                                                       ? std::min(requestedLimits.chargeCurrentA, temperatureLimits.chargeA)
                                                       : 0.0;
            const double requestedDischargeCurrentA = snapshot.valid && snapshot.dischargeAllowed
                                                          ? std::min(requestedLimits.dischargeCurrentA, temperatureLimits.dischargeA)
                                                          : 0.0;
            publishedChargeCurrentLimitA = BatteryLimits::applyRecoverySlew(
                publishedChargeCurrentLimitA,
                requestedChargeCurrentA,
                settings.SAFETY_LIMITS.CHARGE_CURRENT_LIMIT,
                inverterLimits.recoveryFractionPerSecond,
                elapsedMs);
            publishedDischargeCurrentLimitA = BatteryLimits::applyRecoverySlew(
                publishedDischargeCurrentLimitA,
                requestedDischargeCurrentA,
                settings.SAFETY_LIMITS.DISCHARGE_CURRENT_LIMIT,
                inverterLimits.recoveryFractionPerSecond,
                elapsedMs);

            snapshot.chargeVoltageV = requestedLimits.chargeVoltageV;
            snapshot.dischargeVoltageV = requestedLimits.dischargeVoltageV;
            snapshot.chargeCurrentA = publishedChargeCurrentLimitA;
            snapshot.dischargeCurrentA = publishedDischargeCurrentLimitA;
            // Enforce the same downward quantization as the CAN codec. Arming
            // begins with the first RUN snapshot; the 5 s dwell covers response
            // latency, not an additional startup grace period.
            const uint16_t chargeDeciA = CurrentLimitGuard::encodeDeciAmps(snapshot.chargeCurrentA);
            const uint16_t dischargeDeciA = CurrentLimitGuard::encodeDeciAmps(snapshot.dischargeCurrentA);
            const uint8_t violation = currentLimitGuard.update(hvConnected,
                snapshot.valid && currentMeasurementConfigured, packCurrent,
                chargeDeciA, dischargeDeciA, now);
            if (violation != 0U)
            {
                taskENTER_CRITICAL();
                currentLimitEvent = {violation, CurrentUnits::microAmps(packCurrent) / 1000,
                    violation == 1U ? chargeDeciA : dischargeDeciA, now};
                taskEXIT_CRITICAL();
            }
            FaultManager::setBmsFault(FaultManager::BmsFault::InverterCurrentLimit, violation != 0U);
            if (violation != 0U)
            {
                snapshot.commonSafe = snapshot.chargeAllowed = snapshot.dischargeAllowed = false;
                snapshot.chargeCurrentA = snapshot.dischargeCurrentA = 0;
                publishedChargeCurrentLimitA = publishedDischargeCurrentLimitA = 0;
            }
            snapshot.averageTemperatureC = NTCtemperatureCount == 0U
                                              ? 0.0
                                              : BCC_TEMPRAW_TO_TEMP(averageNTCtemperature);
            snapshot.cellCount = cellCount;

            summary.valid = snapshot.valid;
            summary.measurementsFresh = snapshot.measurementsFresh;
            summary.socValid = snapshot.socValid;
            summary.currentSensingEnabled = snapshot.currentSensingEnabled;
            summary.sequence = publishedSequence;
            summary.packVoltageUv = snapshot.packVoltageUv;
            summary.packCurrentA = snapshot.packCurrentA;
            summary.minCellVoltageUv = minCellVoltage;
            summary.maxCellVoltageUv = maxCellVoltage;
            summary.minNtcTemperatureRaw = minNTCtemperature;
            summary.maxNtcTemperatureRaw = maxNTCtemperature;
            summary.minIcTemperatureRaw = minICtemperature;
            summary.maxIcTemperatureRaw = maxICtemperature;
            for (size_t slaveIndex = 0U; slaveIndex < mSlaves.size(); ++slaveIndex)
            {
                MonitorMeasurements &monitor = measurement.monitors[slaveIndex];
                uint16_t mask = 0U;
                for (uint8_t cellIndex = 0U; cellIndex < 12U; ++cellIndex)
                {
                    if (mSlaves[slaveIndex].isCellBalancing(cellIndex))
                    {
                        mask |= static_cast<uint16_t>(1U << cellIndex);
                    }
                }
                monitor.balancingMask = mask;
            }

            if (snapshot.socValid)
            {
                // GoodWe stops charging at 100%. Only advertise full after
                // the cell-voltage/current dwell has calibrated the counter.
                snapshot.socPercent = BatterySoc::inverterPercent(
                    liveSoC(), fullChargeConfirmed);
            }
            summary.socRaw = snapshot.socValid ? liveSoC() : 0U;

            Watchdog::setBccPhase(Watchdog::BccPhase::EnergyUpdate);
            EnergyCounter::update(summary.packVoltageUv,
                                  CurrentUnits::microAmps(summary.packCurrentA),
                                  currentMeasurementConfigured ? mSlaves[currentMeasurementSlaveIdx].currentSampleTimeUs() : micros(),
                                  summary.valid && summary.measurementsFresh &&
                                      summary.currentSensingEnabled &&
                                      mSlaves[currentMeasurementSlaveIdx].currentIntervalValid());

            Watchdog::setBccPhase(Watchdog::BccPhase::SnapshotPublication);
            bool framePublished = false;
            if (summary.valid)
            {
                MeasurementFrameLock lock(kMeasurementFrameLockTimeout);
                if (lock.acquired())
                {
                    framePublished = copyActiveMeasurementFrame(measurement, latestMeasurementFrame);
                }
            }

            if (framePublished)
            {
                publishedMeasurementValid.store(summary.valid, std::memory_order_release);
                publishedMeasurementsFresh.store(summary.measurementsFresh, std::memory_order_release);
                measurementSequence.store(publishedSequence, std::memory_order_release);
            }
            else if (!summary.valid)
            {
                publishedMeasurementValid.store(false, std::memory_order_release);
                publishedMeasurementsFresh.store(summary.measurementsFresh, std::memory_order_release);
            }
            else
            {
                publishedMeasurementsFresh.store(false, std::memory_order_release);
                snapshot.measurementsFresh = false;
                snapshot.commonSafe = false;
                snapshot.chargeAllowed = false;
                snapshot.dischargeAllowed = false;
                snapshot.chargeCurrentA = 0.0;
                snapshot.dischargeCurrentA = 0.0;
            }

            taskENTER_CRITICAL();
            latestBatteryCanSnapshot = snapshot;
            if (snapshot.valid && !snapshot.communicationFault)
            {
                lastValidBatteryCanSnapshot = snapshot;
                hasValidBatteryCanSnapshot = true;
            }
            taskEXIT_CRITICAL();
        }

        // Balancing is allowed only with a healthy, fully running BMS.
        bool isBalancingAllowed()
        {
            const FaultManager::Snapshot snapshot = FaultManager::getSnapshot();
            return balancingEnabled.load(std::memory_order_relaxed) &&
                   currentState == RUNNING &&
                   completeMeasurementSetValid &&
                   measurementsAreFresh() &&
                   currentMeasurementConfigured &&
                   (snapshot.bmsActive | snapshot.bmsLatched |
                    snapshot.hvActive | snapshot.hvLatched) == 0U;
        }

        bool disableCellBalancing(bool clearChannelConfiguration)
        {
            bool successful = true;
            for (size_t slaveIndex = 0U; slaveIndex < mSlaves.size(); ++slaveIndex)
            {
                auto &slave = mSlaves[slaveIndex];
                accumulateBalancingCharge(slaveIndex, millis());
                const bool driverDisabled = slave.CB_Enable(false) == BCC_STATUS_SUCCESS;
                if (driverDisabled) balancingAccountingTimelines[slaveIndex].stop(millis());
                else balancingAccountingTimelines[slaveIndex].invalidate(millis());
                successful = driverDisabled && successful;
                if (driverDisabled && clearChannelConfiguration)
                {
                    successful = slave.CB_ClearAllChannels() == BCC_STATUS_SUCCESS && successful;
                }
            }

            activeBalancingMasks.fill(0U);
            balancingCycleActive = false;
            balancingCycleEndMs = 0U;
            // Without clearing CBx_CFG, a future CB_DRVEN enable must first
            // assume that stale channel selections remain in the BCC.
            balancingHardwareStateKnown = successful && clearChannelConfiguration;
            return successful;
        }

        bool balancingCycleHasEnded(uint32_t now)
        {
            return static_cast<int32_t>(now - balancingCycleEndMs) >= 0;
        }

        uint32_t balancingPulseDurationMs()
        {
            return cBalancingTime == 0U
                       ? BatteryBalancing::ShortPulseMs
                       : static_cast<uint32_t>(cBalancingTime) * 60'000U;
        }

        bool configureBalancingCycle(
            const std::array<uint16_t, RuntimeConfiguration::MAX_SLAVES> &desiredMasks,
            const std::array<uint8_t, RuntimeConfiguration::MAX_SLAVES> &nextStartIndices)
        {
            // NXP requires CBx_CFG to be programmed while CB_DRVEN is off.
            // Clearing every channel prevents an earlier selection from
            // restarting when the global driver is enabled again.
            if (!disableCellBalancing(true))
            {
                return false;
            }

            bool anyCellSelected = false;
            for (size_t slaveIndex = 0U; slaveIndex < mSlaves.size(); ++slaveIndex)
            {
                const uint16_t desiredMask = desiredMasks[slaveIndex];
                anyCellSelected = desiredMask != 0U || anyCellSelected;
                for (uint8_t cellIndex = 0U;
                     cellIndex < mSlaves[slaveIndex].getCellCount();
                     ++cellIndex)
                {
                    if ((desiredMask & (1U << cellIndex)) != 0U &&
                        mSlaves[slaveIndex].CB_SetIndividualCell(
                            cellIndex, true, cBalancingTime) != BCC_STATUS_SUCCESS)
                    {
                        (void)disableCellBalancing(false);
                        return false;
                    }
                }
            }

            if (!anyCellSelected)
            {
                balancingSelectionStartIndices = nextStartIndices;
                updateFault(CELL_BALANCING_FAULT, false);
                return true;
            }

            std::array<uint32_t, RuntimeConfiguration::MAX_SLAVES> enabledAtMs{};
            for (size_t slaveIndex = 0U; slaveIndex < mSlaves.size(); ++slaveIndex)
            {
                if (mSlaves[slaveIndex].CB_Enable(true) != BCC_STATUS_SUCCESS)
                {
                    (void)disableCellBalancing(false);
                    return false;
                }
                enabledAtMs[slaveIndex] = millis();
            }

            // The specified maximum driver turn-on time is 450 us.
            delay(1U);
            bool statusMatches = true;
            for (size_t slaveIndex = 0U; slaveIndex < mSlaves.size(); ++slaveIndex)
            {
                uint16_t activeMask = 0U;
                if (mSlaves[slaveIndex].CB_GetActiveCellMask(&activeMask) != BCC_STATUS_SUCCESS)
                {
                    (void)disableCellBalancing(false);
                    return false;
                }
                statusMatches = activeMask == desiredMasks[slaveIndex] && statusMatches;
            }

            if (!statusMatches)
            {
                PRINTF_ERR("[SC] Cell-balancing driver status did not match the requested mask\n");
                updateFault(CELL_BALANCING_FAULT, true);
                (void)disableCellBalancing(true);
                // Communication succeeded; this is a balancing-hardware fault,
                // not a reason to consume a communication retry.
                return true;
            }

            activeBalancingMasks = desiredMasks;
            balancingSelectionStartIndices = nextStartIndices;
            balancingHardwareStateKnown = true;
            balancingCycleActive = true;
            balancingCycleEndMs = millis() + balancingPulseDurationMs();
            for (size_t slaveIndex = 0U; slaveIndex < mSlaves.size(); ++slaveIndex)
            {
                balancingAccountingTimelines[slaveIndex].start(
                    enabledAtMs[slaveIndex], balancingPulseDurationMs());
            }
            updateFault(CELL_BALANCING_FAULT, false);
            return true;
        }

        bool performCellBalancing()
        {
            if (!isBalancingAllowed())
            {
                balancingCurrentQualification.reset();
                if (balancingHardwareStateKnown && !balancingCycleActive)
                {
                    updateFault(CELL_BALANCING_FAULT, false);
                    return true;
                }

                const bool disabled = disableCellBalancing(true);
                if (disabled)
                {
                    updateFault(CELL_BALANCING_FAULT, false);
                }
                return disabled;
            }

            const uint32_t now = millis();
            const bool currentQualified = balancingCurrentQualification.update(
                BatteryBalancing::currentAllowsBalancing(
                    packCurrent, batteryCapacityAh(), settings.BALANCING_MIN_CURRENT,
                    settings.BALANCING_MAX_CURRENT_C), now);
            // A current excursion prevents the next pulse but need not interrupt
            // this 30-second pulse. Safety conditions above still stop it.
            if (balancingCycleActive && !balancingCycleHasEnded(now))
            {
                return true;
            }

            if (!currentQualified)
            {
                if (balancingHardwareStateKnown && !balancingCycleActive) return true;
                return disableCellBalancing(true);
            }

            const uint32_t minimumVoltageUv = static_cast<uint32_t>(
                settings.MIN_BALANCING_VOLTAGE * 1'000'000.0);
            const uint32_t startDifferenceUv = static_cast<uint32_t>(
                settings.MIN_BALANCING_DIFF_VOLTAGE * 1'000'000.0);
            const uint32_t stopDifferenceUv = static_cast<uint32_t>(
                settings.STOP_BALANCING_DIFF_VOLTAGE * 1'000'000.0);
            std::array<uint16_t, RuntimeConfiguration::MAX_SLAVES> desiredMasks{};
            std::array<uint8_t, RuntimeConfiguration::MAX_SLAVES> nextStartIndices =
                balancingSelectionStartIndices;
            bool anyCellSelected = false;

            for (size_t slaveIndex = 0U; slaveIndex < mSlaves.size(); ++slaveIndex)
            {
                const BatteryBalancing::Selection selection = BatteryBalancing::selectCells(
                    std::span<const uint32_t>(workingMeasurementFrame.monitors[slaveIndex].cellVoltagesUv.data(),
                                              workingMeasurementFrame.monitors[slaveIndex].cellCount),
                    minCellVoltage,
                    minimumVoltageUv,
                    startDifferenceUv,
                    stopDifferenceUv,
                    activeBalancingMasks[slaveIndex],
                    balancingSelectionStartIndices[slaveIndex],
                    settings.MAX_SIMULTANEOUS_BALANCING_CELLS_PER_SLAVE);
                desiredMasks[slaveIndex] = selection.mask;
                nextStartIndices[slaveIndex] = selection.nextStartIndex;
                anyCellSelected = selection.mask != 0U || anyCellSelected;
            }

            // Avoid rewriting every CBx_CFG register on each 50 ms loop while
            // the known-safe desired state remains "all channels off".
            if (!anyCellSelected && balancingHardwareStateKnown && !balancingCycleActive)
            {
                balancingSelectionStartIndices = nextStartIndices;
                updateFault(CELL_BALANCING_FAULT, false);
                return true;
            }

            return configureBalancingCycle(desiredMasks, nextStartIndices);
        }

        uint16_t diagnosticFailureMask(const BCC_Diagnostics::diags_t &result)
        {
            return static_cast<uint16_t>(
                (result.ADC1VER ? (1U << BCC_Diagnostics::ADC1VER) : 0U) |
                (result.OVUVVER ? (1U << BCC_Diagnostics::OVUVVER) : 0U) |
                (result.OVUVDET ? (1U << BCC_Diagnostics::OVUVDET) : 0U) |
                (result.CTXOPEN ? (1U << BCC_Diagnostics::CTXOPEN) : 0U) |
                (result.CELLVOLT ? (1U << BCC_Diagnostics::CELLVOLT) : 0U) |
                (result.CONNRES ? (1U << BCC_Diagnostics::CONNRES) : 0U) |
                (result.CTXLEAK ? (1U << BCC_Diagnostics::CTXLEAK) : 0U) |
                (result.CURRMEAS ? (1U << BCC_Diagnostics::CURRMEAS) : 0U) |
                (result.SHUNTNOTCONN ? (1U << BCC_Diagnostics::SHUNTNOTCONN) : 0U) |
                (result.GPIOXOTUT ? (1U << BCC_Diagnostics::GPIOXOTUT) : 0U) |
                (result.GPIOXOPEN ? (1U << BCC_Diagnostics::GPIOXOPEN) : 0U) |
                (result.CBXOPEN ? (1U << BCC_Diagnostics::CBXOPEN) : 0U));
        }

        bool diagnostics()
        {
            for (auto &slave : mSlaves) slave.resetCurrentBaseline();
            const size_t reportCount = std::min(mSlaves.size(), diagnosticReports.size());
            if (diagnosticAttempt != UINT16_MAX) ++diagnosticAttempt;
            bool success = true;
            // Start measuring the time it takes to perform the diagnostics
            uint32_t startMicros = micros();
            for (size_t index = 0U; index < reportCount; ++index)
            {
                auto &slave = mSlaves[index];
                BCC_Diagnostics::diags_t result{};
                uint8_t failedDiagnostic = BCC_Diagnostics::DIAGNOSTIC_NONE;
                slave.clearRegisterTrace();
                const bcc_status_t diagnosticStatus = BCC_Diagnostics::runStartupChecks(
                    &slave, settings.SAFETY_LIMITS, &result, &failedDiagnostic,
                    Watchdog::reportBccProgress);
                const uint16_t failedChecks = diagnosticFailureMask(result);
                const DiagnosticReport report = {
                    .cid = slave.getCID(),
                    .failedChecks = failedChecks,
                    .status = static_cast<uint8_t>(diagnosticStatus),
                    .failedDiagnostic = failedDiagnostic,
                    .trace = slave.getRegisterTrace(),
                    .attempt = diagnosticAttempt,
                    .gpioOpenMask = static_cast<uint8_t>(result.gpioOpenMask),
                    .gpioCheckedMask = StartupDiagnostics::temperatureInputMask(slave.getNTCCount()),
                };
                taskENTER_CRITICAL();
                StartupDiagnostics::retainFirstFailure(diagnosticReports[index], report);
                diagnosticReportCount = std::max(diagnosticReportCount, index + 1U);
                taskEXIT_CRITICAL();
                if (diagnosticStatus != BCC_STATUS_SUCCESS)
                {
                    success = false;
                }

                // Check if the result is not 0
                if (failedChecks != 0U)
                {
                    success = false;
                    PRINTF_INFO("[SC] Some diagnostics failed on CID %u: %04X\n", slave.getCID(), failedChecks);
                    PRINTF_INFO("  ADC1VER: %s\n", result.ADC1VER ? "FAIL" : "OK");
                    PRINTF_INFO("  OVUVVER: %s\n", result.OVUVVER ? "FAIL" : "OK");
                    PRINTF_INFO("  OVUVDET: %s\n", result.OVUVDET ? "FAIL" : "OK");
                    PRINTF_INFO("  CTXOPEN: %s\n", result.CTXOPEN ? "FAIL" : "OK");
                    PRINTF_INFO("  CELLVOLT: %s\n", result.CELLVOLT ? "FAIL" : "OK");
                    PRINTF_INFO("  CONNRES: %s\n", result.CONNRES ? "FAIL" : "OK");
                    PRINTF_INFO("  CTXLEAK: %s\n", result.CTXLEAK ? "FAIL" : "OK");
                    PRINTF_INFO("  CURRMEAS: %s\n", result.CURRMEAS ? "FAIL" : "OK");
                    PRINTF_INFO("  SHUNTNOTCONN: %s\n", result.SHUNTNOTCONN ? "FAIL" : "OK");
                    PRINTF_INFO("  GPIOXOTUT: %s\n", result.GPIOXOTUT ? "FAIL" : "OK");
                    PRINTF_INFO("  GPIOXOPEN: %s\n", result.GPIOXOPEN ? "FAIL" : "OK");
                    PRINTF_INFO("  CBXOPEN: %s\n", result.CBXOPEN ? "FAIL" : "OK");
                }

            }
            double diagTimeMS = (micros() - startMicros) / 1000.0;
            PRINTF_INFO("[SC] Diagnostics took %.2f ms, on average %.2f ms per slave\n", diagTimeMS, diagTimeMS / getNumOfSlaves());
            return success;
        }

        void handleRegisterRequests()
        {
            RegisterRequest request;

            taskENTER_CRITICAL();
            if (!registerRequestBusy || registerRequest.cid == 0U)
            {
                taskEXIT_CRITICAL();
                return;
            }

            request = registerRequest;
            taskEXIT_CRITICAL();

            PRINTF_INFO("[SC] Processing register request\n");
            RegisterReponse response = {};
            response.status = mSlaves[request.cid - 1U].regRead(request.regAddr, 1, &response.regValue);

            taskENTER_CRITICAL();
            registerResponse = response;
            registerResponseReady = true;
            registerRequest = {};
            registerRequestBusy = false;
            taskEXIT_CRITICAL();
        }

        void runningLoop()
        {
            // PRINTF_ERR("[SC] Running loop in state: %d\n", (currentState));
            // ADC conversions
            Watchdog::setBccPhase(Watchdog::BccPhase::MeasurementStart);
            const bool conversionSuccessful = startMeasurements();
            if (!conversionSuccessful)
            {
                temperatureController.reset();
                currentLimitGuard.update(PCC::getPCCState() == PCC::RUN, false, 0, 0, 0, millis());
                balancingCurrentQualification.reset();
                completeMeasurementSetValid = false;
                Watchdog::setBccPhase(Watchdog::BccPhase::PresenceCheck);
                if (doCommunicationCheck(false))
                {
                    // A live TPL loss invalidates CID assignment and/or
                    // monitor configuration. Safe-off has already occurred
                    // through the FaultManager on the third failed attempt.
                    PRINTF_WARN("[SC] Communication lost; restarting TPL initialization\n");
                    setState(DEVICE_INITIALIZATION);
                    initializationRetryNotBeforeMs = millis();
                }
                else
                {
                    Watchdog::setBccPhase(Watchdog::BccPhase::SnapshotPublication);
                    publishHeldBatteryCanSnapshot();
                }
                return;
            }

            Watchdog::setBccPhase(Watchdog::BccPhase::MeasurementRead);
            const bool measurementsSuccessful = getMeasurements();
            completeMeasurementSetValid = measurementsSuccessful;
            if (!measurementsSuccessful)
            {
                temperatureController.reset();
                currentLimitGuard.update(PCC::getPCCState() == PCC::RUN, false, 0, 0, 0, millis());
                balancingCurrentQualification.reset();
                Watchdog::setBccPhase(Watchdog::BccPhase::PresenceCheck);
                if (doCommunicationCheck(false))
                {
                    PRINTF_WARN("[SC] Communication lost; restarting TPL initialization\n");
                    setState(DEVICE_INITIALIZATION);
                    initializationRetryNotBeforeMs = millis();
                }
                else
                {
                    Watchdog::setBccPhase(Watchdog::BccPhase::SnapshotPublication);
                    publishHeldBatteryCanSnapshot();
                }
                return;
            }

            // Handle register requests from Companion
            Watchdog::setBccPhase(Watchdog::BccPhase::RegisterRequests);
            handleRegisterRequests();

            Watchdog::setBccPhase(Watchdog::BccPhase::FaultDetection);
            const bool faultStatusSuccessful = faultDetection();
            if (!faultStatusSuccessful)
            {
                temperatureController.reset();
                currentLimitGuard.update(PCC::getPCCState() == PCC::RUN, false, 0, 0, 0, millis());
            }
            if (!faultStatusSuccessful) balancingCurrentQualification.reset();
            // Select balancing channels only after this cycle's current and
            // fault status are known. A failed fault read skips balancing.
            Watchdog::setBccPhase(Watchdog::BccPhase::Balancing);
            const bool balancingSuccessful = faultStatusSuccessful && performCellBalancing();

            Watchdog::setBccPhase(Watchdog::BccPhase::PresenceCheck);
            if (doCommunicationCheck(faultStatusSuccessful && balancingSuccessful))
            {
                // A live TPL loss invalidates CID assignment and/or monitor
                // configuration.  Safe-off has already occurred through the
                // FaultManager; retry the complete recoverable chain path.
                PRINTF_WARN("[SC] Communication lost; restarting TPL initialization\n");
                setState(DEVICE_INITIALIZATION);
                initializationRetryNotBeforeMs = millis();
            }
            else if (communicationFaultActive)
            {
                Watchdog::setBccPhase(Watchdog::BccPhase::SnapshotPublication);
                publishHeldBatteryCanSnapshot();
                return;
            }

            const uint32_t publishedSequence = completeMeasurementSetValid
                                                    ? measurementSequence.load(std::memory_order_relaxed) + 1U
                                                    : measurementSequence.load(std::memory_order_relaxed);
            Watchdog::setBccPhase(Watchdog::BccPhase::SnapshotPublication);
            publishBatteryCanSnapshot(publishedSequence);
        }

        bcc_status_t globalSoftwareReset()
        {
            return BCC::regWriteGlobal(MC33771C_SYS_CFG1_OFFSET,
                                       MC33771C_SYS_CFG1_SOFT_RST(MC33771C_SYS_CFG1_SOFT_RST_ACTIVE_ENUM_VAL));
        }

        /*!
         * @brief This function wakes device(s) up, resets them (if needed), assigns
         * CIDs and checks the communication.
         *
         * @return bcc_status_t Error code.
         */
        bool InitDevices()
        {
            bcc_status_t status;

            /* Wake-up all configured devices (in case they are in SLEEP mode) or
             * move the first device (device closest to MC33664) from IDLE mode to
             * NORMAL mode (in case devices are in IDLE mode). */
            BCC_Communication::wakeUpPattern(mSlaves.size());

            /* Software Reset all configured devices (in case they are already initialized).
             * If the devices are not initialized (CID is equal to 000000b), a write
             * command is sent via communication interface, but the software reset is
             */
            (void)globalSoftwareReset();

            /* Wait for 5 ms - for the IC to be ready for initialization. */
            BCC_MCU_WaitMs(BCC_T_VPWR_READY_MS);

            /* Assign CID to the first node and terminate its RDTX_OUT if only one
             * device is utilised and if loop-back is not required. */

            status = mSlaves[0].assignCid(mSlaves.size());

            if (status != BCC_STATUS_SUCCESS)
            {
                uint8_t &failureCount = cidInitializationFailureCounts[0];
                failureCount++;
                PRINTF_ERR("Failed to assign CID 1 (%u/%u), status code: %lu\n",
                           failureCount,
                           CID_INITIALIZATION_MAX_FAILURES,
                           (uint32_t)status);
                if (failureCount >= CID_INITIALIZATION_MAX_FAILURES)
                {
                    updateFault(CID_INITIALIZATION_FAULT, true);
                }
                return false;
            }
            cidInitializationFailureCounts[0] = 0U;

            /* Init the rest of devices. */
            for (uint8_t i = 1; i < mSlaves.size(); i++)
            {
                BCC_MCU_WaitMs(2U);

                /* Move the following device from IDLE to NORMAL mode (in case the
                 * devices are in IDLE mode).
                 * Note that the WAKE-UP sequence is recognised as two wrong SPI
                 * transfers in devices which are already in the NORMAL mode. That will
                 * increase their COM_STATUS[COM_ERR_COUNT]. */
                BCC_Communication::wakeUpPattern(mSlaves.size());

                status = mSlaves[i].assignCid(mSlaves.size());
                if (status != BCC_STATUS_SUCCESS)
                {
                    uint8_t &failureCount = cidInitializationFailureCounts[i];
                    failureCount++;
                    PRINTF_ERR("Failed to assign CID %u (%u/%u), status code: %lu\n",
                               mSlaves[i].getCID(),
                               failureCount,
                               CID_INITIALIZATION_MAX_FAILURES,
                               (uint32_t)status);
                    if (failureCount >= CID_INITIALIZATION_MAX_FAILURES)
                    {
                        updateFault(CID_INITIALIZATION_FAULT, true);
                    }
                    return false;
                }
                cidInitializationFailureCounts[i] = 0U;
            }

            updateFault(CID_INITIALIZATION_FAULT, false);
            return true;
        }

        /*!
         * @brief This function sets sleep mode to all battery cell controller devices.
         *
         * In case of TPL communication mode, MC33664 has to be put into the sleep mode
         * separately, by the BCC_TPL_Disable function.
         *
         * @return bcc_status_t Error code.
         */
        bcc_status_t Sleep()
        {
            return BCC::regWriteGlobal(MC33771C_SYS_CFG_GLOBAL_OFFSET, MC33771C_SYS_CFG_GLOBAL_GO2SLEEP(MC33771C_SYS_CFG_GLOBAL_GO2SLEEP_ENABLED_ENUM_VAL));
        }

        /**
         * @brief freeRTOS task for SlaveController
         */
        void task(void *argument)
        {
            uint32_t startTick = osKernelGetTickCount(); // Keep track of the time since the task started
            selfDischargeLastTickMs = millis();
            while (true)
            {
				Watchdog::reportBccProgress();
				Watchdog::setBccPhase(Watchdog::BccPhase::LoopStart);

                // Execute ahead of state-specific returns so communication
                // errors, retries, and CRITICAL supervision still apply the
                // model whenever the retained SoC counter is valid.
                updateSelfDischarge(millis());

				if (currentState == CRITICAL)
				{
					Watchdog::setBccPhase(Watchdog::BccPhase::Critical);
					// Keep platform supervision alive while exposing the critical state.
					osDelay(20U);
					continue;
				}

				const bool initializationRetryDue =
					static_cast<int32_t>(millis() - initializationRetryNotBeforeMs) >= 0;

                if (currentState == DEVICE_INITIALIZATION && initializationRetryDue)
                {
                    Watchdog::setBccPhase(Watchdog::BccPhase::DeviceInitialization);
                    // 1. TPL plus daisy chain / CID initialization.
                    const bool tplReady = BCC_Communication::TPL_Enable() == BCC_STATUS_SUCCESS;
                    if (!tplReady)
                    {
                        ++tplInitializationFailureCount;
                        if (tplInitializationFailureCount >= CID_INITIALIZATION_MAX_FAILURES)
                        {
                            updateFault(TPL_FAULT, true);
                        }
						initializationRetryNotBeforeMs = millis() + 2000U;
                    }
                    else
                    {
                        tplInitializationFailureCount = 0U;
                        updateFault(TPL_FAULT, false);
                        if (!InitDevices())
                        {
                            // Retry the complete chain after a short delay. A
                            // source only becomes an ERROR once its own retry
                            // budget is exhausted in InitDevices().
							initializationRetryNotBeforeMs = millis() + 2000U;
                        }
                        else
                        {
                            setState(REGISTER_INITIALIZATION);
                        }
                    }
                }

                if (currentState == REGISTER_INITIALIZATION && initializationRetryDue)
                {
					Watchdog::setBccPhase(Watchdog::BccPhase::RegisterInitialization);

                    // 2. Register initialization
                    if (!initializeRegisters())
                    {
                        ++registerInitializationFailureCount;
                        if (registerInitializationFailureCount >= CID_INITIALIZATION_MAX_FAILURES)
                        {
                            updateFault(REGISTER_INITIALIZATION_FAULT, true);
                        }
						initializationRetryNotBeforeMs = millis() + 2000U;
                    }
                    else
                    {
                        registerInitializationFailureCount = 0U;
                        updateFault(REGISTER_INITIALIZATION_FAULT, false);
                        setState(PERFORMING_DIAGNOSTICS);
                    }
                }

                if (currentState == PERFORMING_DIAGNOSTICS && initializationRetryDue)
                {
                    Watchdog::setBccPhase(Watchdog::BccPhase::Diagnostics);
                    // 5. Diagnostics
                    bool diagnosticsSuccessful = true;
                    if (startupDiagnosticsEnabled)
                    {
                        diagnosticsSuccessful = diagnostics();
                    }
                    else
                    {
                        PRINTF_ERR("[SC] WARNING: startup diagnostics are disabled for bench testing\n");
                    }
                    if (!diagnosticsSuccessful)
                    {
                        if (diagnosticsFailureCount < CID_INITIALIZATION_MAX_FAILURES)
                        {
                            ++diagnosticsFailureCount;
                        }
                        if (diagnosticsFailureCount >= CID_INITIALIZATION_MAX_FAILURES)
                        {
                            updateFault(DIAGNOSTICS_FAULT, true);
                        }
                        else
                        {
                            updateFault(DIAGNOSTICS_FAULT, false);
                        }
                        // The retry delay exceeds the BCC's 1024 ms COM reset.
                        // Reassign CIDs and restore registers before diagnosing again.
                        setState(DEVICE_INITIALIZATION);
						initializationRetryNotBeforeMs = millis() + 2000U;
                    }
                    else
                    {
                        diagnosticsFailureCount = 0U;
                        updateFault(DIAGNOSTICS_FAULT, false);
                        Watchdog::setBccPhase(Watchdog::BccPhase::MeasurementStart);
                        const bool conversionSuccessful = startMeasurements();
                        Watchdog::setBccPhase(Watchdog::BccPhase::MeasurementRead);
                        const bool measurementsSuccessful = conversionSuccessful && getMeasurements(true);
                        completeMeasurementSetValid = conversionSuccessful && measurementsSuccessful;

                        bool faultStatusSuccessful = false;
                        if (measurementsSuccessful)
                        {
                            Watchdog::setBccPhase(Watchdog::BccPhase::FaultDetection);
                            faultStatusSuccessful = faultDetection();
                        }
                        Watchdog::setBccPhase(Watchdog::BccPhase::PresenceCheck);
                        const bool communicationHardFault = doCommunicationCheck(faultStatusSuccessful);
                        if (communicationHardFault)
                        {
                            PRINTF_WARN("[SC] Communication lost during startup; retrying TPL initialization\n");
                            setState(DEVICE_INITIALIZATION);
                            initializationRetryNotBeforeMs = millis();
                        }
                        else
                        {
                            setState(RUNNING);
                            FaultManager::setStartupComplete(true);
                            const uint32_t publishedSequence = completeMeasurementSetValid
                                                                    ? measurementSequence.load(std::memory_order_relaxed) + 1U
                                                                    : measurementSequence.load(std::memory_order_relaxed);
                            if (communicationFaultActive)
                            {
                                Watchdog::setBccPhase(Watchdog::BccPhase::SnapshotPublication);
                                publishHeldBatteryCanSnapshot();
                            }
                            else
                            {
                                Watchdog::setBccPhase(Watchdog::BccPhase::SnapshotPublication);
                                publishBatteryCanSnapshot(publishedSequence);
                            }
                        }
                    }
                }

                if (currentState == RUNNING)
                {
                    runningLoop();
                }
                else
                {
                    // The same BCC task owns these bounded reads during startup
                    // and fault retry waits; no second SPI owner or mutex needed.
                    handleRegisterRequests();
                }

                if (currentState == CRITICAL)
                {
                    Watchdog::setBccPhase(Watchdog::BccPhase::Critical);
                    // Configuration is unrecoverable by current software.
                }

                // Schedule the next loop iteration BMS_MAIN_LOOP_PERIOD ms after this one to achieve constant frequency
                Watchdog::setBccPhase(Watchdog::BccPhase::Delay);
                osDelayUntil(startTick += settings.BMS_MAIN_LOOP_PERIOD / portTICK_PERIOD_MS);
            }
        }

        /**
         * @brief Load static defaults and the Companion-managed runtime configuration from NV
         * @return true if the configuration is valid, false otherwise
         */
        bool loadConfig()
        {
            const RuntimeConfiguration::LoadResult persisted = RuntimeConfiguration::load();
            if (persisted.status != RuntimeConfiguration::LoadStatus::Valid)
            {
                PRINTF_ERR("[SC] No usable runtime configuration in FLASH (status %u, stored version %u, expected %u)\n",
                           static_cast<unsigned>(persisted.status), persisted.storedVersion,
                           RuntimeConfiguration::CONFIG_VERSION);
                return false;
            }

            if (!validateRuntimeConfiguration(persisted.values))
            {
                return false;
            }

            if (settings.MIN_BALANCING_VOLTAGE <
                    settings.INVERTER_LIMITS.CHARGE_DERATING_START_CELL_VOLTAGE ||
                settings.MIN_BALANCING_VOLTAGE >=
                    settings.INVERTER_LIMITS.CHARGE_TARGET_CELL_VOLTAGE ||
                settings.MIN_BALANCING_DIFF_VOLTAGE <= 0.0 ||
                settings.STOP_BALANCING_DIFF_VOLTAGE < 0.0 ||
                settings.STOP_BALANCING_DIFF_VOLTAGE >=
                    settings.MIN_BALANCING_DIFF_VOLTAGE ||
                settings.BALANCING_MAX_CURRENT_C <= 0.0 ||
                settings.MAX_SIMULTANEOUS_BALANCING_CELLS_PER_SLAVE == 0U ||
                settings.MAX_SIMULTANEOUS_BALANCING_CELLS_PER_SLAVE >
                    settings.SLAVE_TEMPLATE.CELL_COUNT)
            {
                PRINTF_ERR("[SC] CONFIG ERR: Invalid static cell-balancing envelope!\n");
                return false;
            }

            runtimeConfiguration = persisted.values;
            activeConfigurationLoaded = true;
            vector<BCC::Config_t> slaveConfigs;
            slaveConfigs.reserve(runtimeConfiguration.slaveCount);
            for (size_t index = 0U; index < runtimeConfiguration.slaveCount; ++index)
            {
                BCC::Config_t config{};
                config.DEVICE_TYPE = settings.SLAVE_TEMPLATE.DEVICE_TYPE;
                config.CELL_COUNT = settings.SLAVE_TEMPLATE.CELL_COUNT;
                config.NTC_COUNT = settings.SLAVE_TEMPLATE.NTC_COUNT;
                config.CURRENT_SENSING_ENABLED =
                    CurrentSensingPolicy::isPackCurrentSource(runtimeConfiguration.currentSenseSlave, static_cast<uint8_t>(index + 1U));
                config.AMPHOUR_BACKUP_REG = config.CURRENT_SENSING_ENABLED
                                                ? settings.SLAVE_TEMPLATE.AMPHOUR_BACKUP_REG
                                                : 0U;
                slaveConfigs.push_back(config);
            }
            balancingEnabled.store(runtimeConfiguration.balanceEnabled, std::memory_order_relaxed);
            startupDiagnosticsEnabled = runtimeConfiguration.startupDiagnostics;
            currentMeasurementConfigured = false;

            for (const BCC::Config_t &config : slaveConfigs)
            {
                const uint8_t first = config.AMPHOUR_BACKUP_REG;
                const uint8_t last = static_cast<uint8_t>(first + 3U);
                constexpr uint8_t energyFirst = EnergyCounter::kChargedEnergyBackupRegister;
                constexpr uint8_t energyLast = EnergyCounter::kMarkerBackupRegister;
                if (first <= energyLast && last >= energyFirst)
                {
                    PRINTF_ERR("[SC] CONFIG ERR: Ah backup registers overlap energy counter storage!\n");
                    return false;
                }
                if (config.CURRENT_SENSING_ENABLED &&
                    first <= BccBreadcrumb::kWatchdogBackupRegister &&
                    last >= BccBreadcrumb::kBackupRegister)
                {
                    PRINTF_ERR("[SC] CONFIG ERR: Ah backup registers overlap reset diagnostics storage!\n");
                    return false;
                }
                if (config.CURRENT_SENSING_ENABLED && first <= kSocCalibrationTimeBackupRegister + 2U && last >= kSocCalibrationDetailsBackupRegister)
                {
                    PRINTF_ERR("[SC] CONFIG ERR: Ah backup registers overlap SoC calibration storage!\n");
                    return false;
                }
            }

            // Verify that the set maximum current is measurable with the given shunt resistance
            const double maxCurrentForShunt = 0.15 / shuntResistanceOhms();
            if (settings.SAFETY_LIMITS.DISCHARGE_CURRENT_LIMIT > maxCurrentForShunt || settings.SAFETY_LIMITS.CHARGE_CURRENT_LIMIT > maxCurrentForShunt)
            {
                PRINTF_ERR("[SC] CONFIG ERR: Current limits are not measurable with the current shunt resistance!\n");
                return false;
            }

            // Verify that the main loop period is achievable
            // If the conversion time is longer than the main loop period, we know for sure that we can't achieve the desired frequency
            const double safetyFactor = 2; // We want to have some margin
            double minConversionTime = (BCC_T_EOC_TIMEOUT_US << BCC_ADC_AVG) / 1000.0;
            minConversionTime += 3.0; // Add 3ms for the settling time of the LP filters
            const double maxBalancingFactor = 1 - (minConversionTime / settings.BMS_MAIN_LOOP_PERIOD);
            if (settings.BMS_MAIN_LOOP_PERIOD < minConversionTime * safetyFactor)
            {
                const double timeOvershootFactor = minConversionTime / (settings.BMS_MAIN_LOOP_PERIOD / safetyFactor);
                const int32_t maxAllowedAveraging = 1 << (int32_t)(static_cast<int32_t>(BCC_ADC_AVG) - ceil(log2(timeOvershootFactor)));
                PRINTF_ERR("[SC] CONFIG ERR: Main loop period is too short for the given averaging and safety margin!\n");
                PRINTF_ERR("    Main loop period: %lu ms\n", settings.BMS_MAIN_LOOP_PERIOD);
                PRINTF_ERR("    Min conversion time: %.2f ms\n", minConversionTime);
                PRINTF_ERR("    Maximum allowed averaging: %ld\n", maxAllowedAveraging);
                return false;
            }

            // Calculate the balancing time based on the capacity of the battery, the balancing resistance and the max balancing factor
            // Print important information about the config
            // Only do this if IMPROVED_BALANCING_ACCURACY is disabled
            if (!settings.IMPROVED_BALANCING_ACCURACY)
            {
                const double batteryDrainedMinutes = (batteryCapacityAh() / (settings.SAFETY_LIMITS.OVERVOLTAGE_LIMIT / BMS_BAL_RESISTANCE)) * 60.0;
                cBalancingTime = lround((batteryDrainedMinutes / maxBalancingFactor) * 0.25e-2);
                PRINTF_WARN("[SC] NOTE: The automagically configured balancing time is %u minutes per trigger\n", cBalancingTime);
            }
            else
            {
                cBalancingTime = 0;
                PRINTF_WARN("[SC] NOTE: Improved balancing accuracy is enabled, using a balancing time of 30s per trigger\n");
            }

            PRINTF_WARN("[SC] NOTE: Current config allows for balancing a maximum of %.1f%% of the time \n", maxBalancingFactor * 100);

            // Create BCC objects and assign CID's starting from 1
            mSlaves.clear();
            currentMeasurementConfigured = false;
            currentMeasurementSlaveIdx = 0U;
            for (size_t i = 0; i < slaveConfigs.size(); i++)
            {
                mSlaves.emplace_back(slaveConfigs[i], i + 1);

                // If the slave is responsible for the current measurement, save the CID
                // For now we only support one slave for current measurement
                if (mSlaves.back().currentSenseEnabled())
                {
                    currentMeasurementSlaveIdx = i;
                    currentMeasurementConfigured = true;
                }

                // Check config of slave last pushed to the array
                if (!mSlaves.back().hasValidConfig())
                {
                    return false;
                }
            }
            cidInitializationFailureCounts.assign(mSlaves.size(), 0U);
            return true;
        }
    }

    /*******************************************************************************
     * Public functions
     ******************************************************************************/
    void setup(CAN *can)
    {
        // Make sure to start at correct state. This also faults the relay driver to be off during startup
        setState(DEVICE_INITIALIZATION);
        measurementFrameMutex = xSemaphoreCreateMutexStatic(&measurementFrameMutexStorage);
        configASSERT(measurementFrameMutex != nullptr);
        FaultManager::setStartupComplete(false);

        BCC_MCU_Assert(can != nullptr);
        mCAN = can;

        if (!loadConfig())
        {
            const RuntimeConfiguration::LoadStatus status = RuntimeConfiguration::load().status;
            if (status == RuntimeConfiguration::LoadStatus::Blank || status == RuntimeConfiguration::LoadStatus::VersionMismatch)
            {
                updateFault(NO_CONFIG, true);
            }
            else
            {
                updateFault(INVALID_CONFIG, true);
            }
            FaultManager::enterCritical();
            setState(CRITICAL);
			bmsTaskHandle = osThreadNew(task, NULL, &bmsTask_attributes);
            return;
        }

        FaultManager::setWarning(FaultManager::Warning::StartupDiagnosticsBypassed,
                                 !startupDiagnosticsEnabled);

        BCC_Communication::setup(settings.TPL_TX_TIMEOUT_MS, settings.TPL_RX_TIMEOUT_MS);

        // Enable backup domain register access
        HAL_PWR_EnableBkUpAccess();
        EnergyCounter::setup();

        if (currentMeasurementConfigured && !mSlaves[currentMeasurementSlaveIdx].ahCounterIsValid())
        {
            mSlaves[currentMeasurementSlaveIdx].invalidateAhCounter();
            PRINTF_WARN("[SC] SoC unavailable until a full-charge calibration\n");
        }

        // Create task 'n stuff
        bmsTaskHandle = osThreadNew(task, NULL, &bmsTask_attributes);
    }

    bool tryGetNewMeasurementFrame(uint32_t &lastSeenMeasurement, MeasurementFrame &destination)
    {
        const uint32_t currentMeasurement = measurementSequence.load(std::memory_order_acquire);
        if (currentMeasurement == lastSeenMeasurement)
        {
            return false;
        }

        MeasurementFrameLock lock(kMeasurementFrameLockTimeout);
        if (!lock.acquired() ||
            !copyNewMeasurementFrame(latestMeasurementFrame,
                                     currentMeasurement,
                                     lastSeenMeasurement,
                                     destination))
        {
            return false;
        }

        destination.summary.valid = publishedMeasurementValid.load(std::memory_order_acquire);
        destination.summary.measurementsFresh = publishedMeasurementsFresh.load(std::memory_order_acquire);
        return true;
    }

    bool areMeasurementsFresh()
    {
        return publishedMeasurementsFresh.load(std::memory_order_acquire);
    }

    uint32_t getMeasurementSequence()
    {
        return measurementSequence.load(std::memory_order_acquire);
    }

    EnergySnapshot getEnergySnapshot()
    {
        const EnergyCounter::Snapshot snapshot = EnergyCounter::getSnapshot();
        return {
            .valid = snapshot.valid,
            .chargedEnergyUWh = snapshot.chargedEnergyUWh,
            .dischargedEnergyUWh = snapshot.dischargedEnergyUWh,
        };
    }

    SelfDischargeSnapshot getSelfDischargeSnapshot()
    {
        taskENTER_CRITICAL();
        const SelfDischargeSnapshot snapshot = publishedSelfDischargeSnapshot;
        taskEXIT_CRITICAL();
        return snapshot;
    }

    bool getBalancingChargeSnapshot(uint8_t slaveIndex, BalancingChargeSnapshot &snapshot)
    {
        snapshot = {};
        if (slaveIndex >= mSlaves.size()) return false;

        const size_t cellCount = std::min<size_t>(
            mSlaves[slaveIndex].getCellCount(), MAX_MEASUREMENT_CELLS);
        std::array<uint32_t, MAX_MEASUREMENT_CELLS> chargeCopy{};
        taskENTER_CRITICAL();
        for (size_t cellIndex = 0U; cellIndex < cellCount; ++cellIndex)
        {
            chargeCopy[cellIndex] = balancingChargeMilliAmpMs[slaveIndex][cellIndex].milliAmpHours;
        }
        taskEXIT_CRITICAL();

        snapshot.cellCount = cellCount;
        for (size_t cellIndex = 0U; cellIndex < cellCount; ++cellIndex)
        {
            snapshot.milliAmpHours[cellIndex] = chargeCopy[cellIndex];
        }
        return true;
    }

    BMSState getState()
    {
        return currentState.load(std::memory_order_acquire);
    }

    size_t getNumOfSlaves()
    {
        return mSlaves.size();
    }

    size_t getCellCount()
    {
        size_t sum = 0;
        for (auto &slave : mSlaves)
        {
            sum += slave.getCellCount();
        }
        return sum;
    }

    uint32_t getPackVoltage()
    {
        return packVoltage.load(std::memory_order_acquire);
    }

    bool isHVReady()
    {
        return currentState.load(std::memory_order_acquire) == RUNNING &&
               FaultManager::canEnableHv() &&
               areMeasurementsFresh();
    }

    SafetyPolicy::Values getSafetyPolicy()
    {
        SafetyPolicy::Values values{};
        values[SafetyPolicy::capacity_mah] = static_cast<int32_t>(std::lround(runtimeConfiguration.batteryCapacityMilliAh));
        values[SafetyPolicy::cold_allowance_deci_c] = static_cast<int32_t>(std::lround(runtimeConfiguration.coldAllowanceDeciC));
        values[SafetyPolicy::charge_derate_mv] = static_cast<int32_t>(std::lround(settings.INVERTER_LIMITS.CHARGE_DERATING_START_CELL_VOLTAGE * 1000));
        values[SafetyPolicy::charge_stop_mv] = static_cast<int32_t>(std::lround(settings.INVERTER_LIMITS.CHARGE_TARGET_CELL_VOLTAGE * 1000));
        values[SafetyPolicy::discharge_derate_mv] = static_cast<int32_t>(std::lround(settings.INVERTER_LIMITS.DISCHARGE_TARGET_CELL_VOLTAGE * 1000));
        values[SafetyPolicy::discharge_stop_mv] = static_cast<int32_t>(std::lround(settings.INVERTER_LIMITS.DISCHARGE_STOP_CELL_VOLTAGE * 1000));
        values[SafetyPolicy::cell_ov_mv] = static_cast<int32_t>(std::lround(settings.SAFETY_LIMITS.OVERVOLTAGE_LIMIT * 1000));
        values[SafetyPolicy::cell_uv_mv] = static_cast<int32_t>(std::lround(settings.SAFETY_LIMITS.UNDERVOLTAGE_LIMIT * 1000));
        values[SafetyPolicy::cell_ot_deci_c] = static_cast<int32_t>(std::lround(settings.SAFETY_LIMITS.OVERTEMPERATURE_LIMIT * 10));
        values[SafetyPolicy::charge_max_ma] = static_cast<int32_t>(std::lround(settings.SAFETY_LIMITS.CHARGE_CURRENT_LIMIT * 1000));
        values[SafetyPolicy::discharge_max_ma] = static_cast<int32_t>(std::lround(settings.SAFETY_LIMITS.DISCHARGE_CURRENT_LIMIT * 1000));
        values[SafetyPolicy::recovery_permille_per_s] = static_cast<int32_t>(std::lround(settings.INVERTER_LIMITS.CURRENT_LIMIT_RECOVERY_RATE * 1000));
        values[SafetyPolicy::cold_stop_deci_c] = static_cast<int32_t>(std::lround(TemperatureLimits::ColdStopC * 10));
        values[SafetyPolicy::cold_recover_deci_c] = static_cast<int32_t>(std::lround(TemperatureLimits::ColdRecoveryC * 10));
        values[SafetyPolicy::cold_t0_deci_c] = static_cast<int32_t>(std::lround(TemperatureLimits::ColdTemperaturesC[0] * 10));
        values[SafetyPolicy::cold_c0_permille] = static_cast<int32_t>(std::lround(TemperatureLimits::ColdRatesC[0] * 1000));
        values[SafetyPolicy::cold_t1_deci_c] = static_cast<int32_t>(std::lround(TemperatureLimits::ColdTemperaturesC[1] * 10));
        values[SafetyPolicy::cold_c1_permille] = static_cast<int32_t>(std::lround(TemperatureLimits::ColdRatesC[1] * 1000));
        values[SafetyPolicy::cold_t2_deci_c] = static_cast<int32_t>(std::lround(TemperatureLimits::ColdTemperaturesC[2] * 10));
        values[SafetyPolicy::cold_c2_permille] = static_cast<int32_t>(std::lround(TemperatureLimits::ColdRatesC[2] * 1000));
        values[SafetyPolicy::cold_t3_deci_c] = static_cast<int32_t>(std::lround(TemperatureLimits::ColdTemperaturesC[3] * 10));
        values[SafetyPolicy::cold_c3_permille] = static_cast<int32_t>(std::lround(TemperatureLimits::ColdRatesC[3] * 1000));
        values[SafetyPolicy::hot_start_deci_c] = static_cast<int32_t>(std::lround(TemperatureLimits::HotStartC * 10));
        values[SafetyPolicy::hot_stop_deci_c] = static_cast<int32_t>(std::lround(TemperatureLimits::HotStopC * 10));
        values[SafetyPolicy::hot_recover_deci_c] = static_cast<int32_t>(std::lround(TemperatureLimits::HotRecoveryC * 10));
        values[SafetyPolicy::hot_c_permille] = static_cast<int32_t>(std::lround(TemperatureLimits::HotRateC * 1000));
        values[SafetyPolicy::zero_tolerance_ma] = static_cast<int32_t>(std::lround(CurrentLimitGuard::ZeroToleranceA * 1000));
        values[SafetyPolicy::limit_margin_ma] = static_cast<int32_t>(std::lround(CurrentLimitGuard::MinimumMarginA * 1000));
        values[SafetyPolicy::limit_margin_permille] = static_cast<int32_t>(std::lround(CurrentLimitGuard::MarginFraction * 1000));
        values[SafetyPolicy::violation_dwell_ms] = static_cast<int32_t>(std::lround(CurrentLimitGuard::DwellMs));
        values[SafetyPolicy::bal_min_mv] = static_cast<int32_t>(std::lround(settings.MIN_BALANCING_VOLTAGE * 1000));
        values[SafetyPolicy::bal_start_delta_mv] = static_cast<int32_t>(std::lround(settings.MIN_BALANCING_DIFF_VOLTAGE * 1000));
        values[SafetyPolicy::bal_stop_delta_mv] = static_cast<int32_t>(std::lround(settings.STOP_BALANCING_DIFF_VOLTAGE * 1000));
        values[SafetyPolicy::bal_min_ma] = static_cast<int32_t>(std::lround(settings.BALANCING_MIN_CURRENT * 1000));
        values[SafetyPolicy::bal_max_c_permille] = static_cast<int32_t>(std::lround(settings.BALANCING_MAX_CURRENT_C * 1000));
        values[SafetyPolicy::bal_qualify_ms] = static_cast<int32_t>(std::lround(BatteryBalancing::QualificationMs));
        values[SafetyPolicy::bal_pulse_ms] = static_cast<int32_t>(std::lround(balancingPulseDurationMs()));
        values[SafetyPolicy::bal_max_cells] = static_cast<int32_t>(std::lround(settings.MAX_SIMULTANEOUS_BALANCING_CELLS_PER_SLAVE));
        values[SafetyPolicy::communication_timeout_ms] = static_cast<int32_t>(std::lround(settings.SAFETY_LIMITS.COMMUNICATION_TIMEOUT));
        values[SafetyPolicy::firmware_version] = static_cast<int32_t>(std::lround(FIRMWARE_VERSION_PACKED));
        values[SafetyPolicy::configuration_valid] = static_cast<int32_t>(std::lround(activeConfigurationLoaded ? 1 : 0));
        values[SafetyPolicy::cell_ov_programmed_uv] = static_cast<int32_t>(std::lround(BCC_GET_TH_CTX(static_cast<uint16_t>(settings.SAFETY_LIMITS.OVERVOLTAGE_LIMIT * 1000)) * 19'500));
        values[SafetyPolicy::cell_uv_programmed_uv] = static_cast<int32_t>(std::lround(BCC_GET_TH_CTX(static_cast<uint16_t>(settings.SAFETY_LIMITS.UNDERVOLTAGE_LIMIT * 1000)) * 19'500));
        return values;
    }

    CurrentLimitGuard::Event getCurrentLimitEvent()
    {
        taskENTER_CRITICAL();
        const auto event = currentLimitEvent;
        taskEXIT_CRITICAL();
        return event;
    }

    bool isChargingAllowed()
    {
        // Low temperature is a charge-only restriction. All other common BMS
        // and HV faults are handled by the shared HV permission.
        return currentState.load(std::memory_order_acquire) == RUNNING &&
               FaultManager::canEnableHv() &&
               areMeasurementsFresh() &&
               !chargeTemperatureInhibit.load(std::memory_order_relaxed);
    }

    bool isDischargingAllowed()
    {
        return currentState.load(std::memory_order_acquire) == RUNNING &&
               FaultManager::canEnableHv() &&
               areMeasurementsFresh() && getBatteryCanSnapshot().dischargeAllowed;
    }

    BatteryCanSnapshot getBatteryCanSnapshot()
    {
        BatteryCanSnapshot snapshot{};
        taskENTER_CRITICAL();
        snapshot = latestBatteryCanSnapshot;
        taskEXIT_CRITICAL();
        return snapshot;
    }

    void setBalancingEnabled(bool enabled)
    {
        balancingEnabled.store(enabled, std::memory_order_relaxed);
    }

    bool isBalancingEnabled()
    {
        return balancingEnabled.load(std::memory_order_relaxed);
    }

    bool getDiagnosticReport(uint8_t slaveIndex, DiagnosticReport &report)
    {
        taskENTER_CRITICAL();
        const bool available = slaveIndex < diagnosticReportCount;
        if (available) report = diagnosticReports[slaveIndex];
        taskEXIT_CRITICAL();
        return available;
    }

    bool validateRuntimeConfiguration(const RuntimeConfiguration::Values &values)
    {
        if (!RuntimeConfiguration::validate(values)) return false;
        const double shuntResistance = values.shuntResistanceMicroOhms / 1'000'000.0;
        const double maxCurrentForShunt = 0.15 / shuntResistance;
        return DEFAULT_STATIC_SETTINGS.SAFETY_LIMITS.DISCHARGE_CURRENT_LIMIT <= maxCurrentForShunt &&
               DEFAULT_STATIC_SETTINGS.SAFETY_LIMITS.CHARGE_CURRENT_LIMIT <= maxCurrentForShunt;
    }

    bool getLastSoCCalibrationUnixTime(uint32_t &unixTime)
    {
        HAL_PWR_EnableBkUpAccess();
        const uint32_t value = *socCalibrationTime;
        if (*socCalibrationMarker != kSocCalibrationMarker ||
            *socCalibrationChecksum != (value ^ kSocCalibrationChecksumXor) ||
            !RtcTime::isSupportedUnixTime(value))
        {
            return false;
        }
        unixTime = value;
        return true;
    }

    void setSoC(uint16_t soc)
    {
        if (!currentMeasurementConfigured) return;
        const double ampHour = std::clamp(
            BCC_SOC_TO_AMPHOUR(soc, batteryCapacityAh()),
            0.0,
            batteryCapacityAh() * 2.0);
        mSlaves[currentMeasurementSlaveIdx].setAhCounter(ampHour);
    }

    bool requestRegister(RegisterRequest requestInfo)
    {
        if (requestInfo.cid == 0U || requestInfo.cid > mSlaves.size())
        {
            return false;
        }

        taskENTER_CRITICAL();
        if (registerRequestBusy)
        {
            taskEXIT_CRITICAL();
            return false;
        }

        registerRequest = requestInfo;
        registerResponse = {};
        registerResponseReady = false;
        registerRequestBusy = true;
        taskEXIT_CRITICAL();
        return true;
    }

    bool getLastSoCCalibrationDetails(SocCalibrationDetails &details)
    {
        HAL_PWR_EnableBkUpAccess();
        const uint32_t marker = socCalibrationDetails[5];
        const uint32_t packedSoc = socCalibrationDetails[0];
        const uint32_t unixTime = socCalibrationDetails[1];
        const uint32_t previousUnixTime = socCalibrationDetails[2];
        const uint32_t dwellMs = socCalibrationDetails[3];
        const uint32_t checksum = socCalibrationDetails[4];
        const bool legacyRecord = marker == kSocCalibrationDetailsMarker;
        const bool extendedRecord = marker == kSocCalibrationDetailsCompleteMarker ||
                                    marker == kSocCalibrationDetailsIncompleteMarker;
        const uint32_t modeledLossMilliAh = extendedRecord ? *socCalibrationSelfDischargeLoss : 0U;
        const uint32_t expectedChecksum = legacyRecord
                                              ? socCalibrationDetailsChecksum(packedSoc, unixTime,
                                                                              previousUnixTime, dwellMs)
                                              : socCalibrationDetailsChecksum(packedSoc, unixTime,
                                                                              previousUnixTime, dwellMs,
                                                                              modeledLossMilliAh, marker);
        if ((!legacyRecord && !extendedRecord) || socCalibrationDetails[5] != marker ||
            checksum != expectedChecksum ||
            (packedSoc & 0xFFFE0000U) != 0U ||
            (unixTime != 0U && !RtcTime::isSupportedUnixTime(unixTime)) ||
            (previousUnixTime != 0U && !RtcTime::isSupportedUnixTime(previousUnixTime))) return false;
        details.unixTimeS = unixTime;
        details.previousUnixTimeS = previousUnixTime;
        details.qualifyingDwellMs = dwellMs;
        details.preCalibrationSocRaw = static_cast<uint16_t>(packedSoc);
        details.preCalibrationSocValid = (packedSoc & (1UL << 16U)) != 0U;
        details.modeledSelfDischargeMilliAh = modeledLossMilliAh;
        details.modeledSelfDischargeValid = extendedRecord && details.preCalibrationSocValid;
        details.modeledSelfDischargeComplete = details.modeledSelfDischargeValid &&
                                                marker == kSocCalibrationDetailsCompleteMarker;
        return true;
    }
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
