bramhut/FlexBMS/(commit log)

2024-02-06 Added Altium projects
    [BMS_Master.PrjPcb, STM32_IO.SchDoc, Top.SchDoc]
2024-02-06 fixed project
    [BMS_Master.PrjPcb, STM32_IO.SchDoc, Top.SchDoc]
2024-02-06 6-2-24 progress
    [BMS_Master.PrjPcb, Power.SchDoc, STM32_IO.SchDoc, Top.SchDoc]
2024-02-07 Add NTC Measurements
    [BMS Slave.PrjPcb, Main.SchDoc, NTC Measurement.SchDoc, Top.SchDoc]
2024-02-07 Add cell terminal/balancing, Isense filter
    [Main.SchDoc, NTC Measurement.SchDoc]
2024-02-07 A bunch of Slave stuff
    [Main.SchDoc, Module Board.SchDoc, Slave.SchDoc]
2024-02-08 Intermediate progress
    [BMS_Master.PrjPcb, STLink_MODS.SchDoc, STM32_IO.SchDoc, Transceivers.SchDoc]
2024-02-08 Slave shit
    [BMS Slave.PrjPcb, Module Board.SchDoc, Slave.SchDoc]
2024-02-08 Good stuff
    [Peripherals.SchDoc, Power.SchDoc, STLink_MODS.SchDoc, STM32_IO.SchDoc, Top.SchDoc, Transceivers.SchDoc]
2024-02-08 Final commit of today
    [BMS_Master.PrjPcb, STM32_IO.SchDoc, Top.SchDoc]
2024-02-09 Some work
    [Peripherals.SchDoc]
2024-02-09 Slave connectores 'n shit
    [BMS Slave.PrjPcb, Module Board.PcbDoc, Module Board.SchDoc, NTC Measurement.SchDoc, Slave.SchDoc]
2024-02-12 Some stuff
    [Peripherals.SchDoc, Power.SchDoc, STM32_IO.SchDoc]
2024-02-12 Progress 12-02
    [BMS_Master.PrjPcb, Connectors.SchDoc, Peripherals.SchDoc, Power.SchDoc, STLink_MODS.SchDoc, STM32_IO.SchDoc, Top.SchDoc, Transceivers.SchDoc]
2024-02-13 More progress
    [BMS_Master.PrjPcb, STM32_IO.SchDoc, Transceivers.SchDoc]
2024-02-13 Started with Slave layout
    [BMS Slave.PrjPcb, Cell Terminal LPF.SchDoc, Module Board.SchDoc, NTC Measurement.SchDoc, Slave.SchDoc]
2024-02-13 Slave stuff
    [Slave.SchDoc]
2024-02-13 Added some generic components
    [BMS_Master.PrjPcb, Peripherals.SchDoc, STLink_MODS.SchDoc, STM32_IO.SchDoc]
2024-02-14 Slave checkpoint
    [Slave.SchDoc]
2024-02-14 Progress 14-02
    [Connectors.SchDoc, Peripherals.SchDoc, Power.SchDoc, STLink_MODS.SchDoc, STM32_IO.SchDoc, Top.SchDoc, Transceivers.SchDoc]
2024-02-15 Intermediate progress 15-02
    [BMS_Master.PrjPcb, Peripherals.SchDoc, Power.SchDoc]
2024-02-15 First few traces Module Board
    [BMS Slave.PrjPcb, Module Board.SchDoc, Slave.SchDoc]
2024-02-16 Progress 16-2
    [Transceivers.SchDoc]
2024-02-19 Progress 19-2
    [Peripherals.SchDoc, STLink_MODS.SchDoc, STM32_IO.SchDoc, Transceivers.SchDoc]
2024-02-20 Sent to Sintecs
    [Power.SchDoc]
2024-02-21 Replaced with GTTstandard components
    [Cell Terminal LPF.SchDoc, Module Board.SchDoc, NTC Measurement.SchDoc, Slave.SchDoc]
2024-02-21 Added power mux
    [Connectors.SchDoc, Peripherals.SchDoc, Power.SchDoc, STLink_MODS.SchDoc, STM32_IO.SchDoc, Transceivers.SchDoc]
2024-02-21 Added parameters to schematic
    [BMS_Master.PrjPcb, Connectors.SchDoc, Peripherals.SchDoc, Power.SchDoc, STLink_MODS.SchDoc, STM32_IO.SchDoc, Top.SchDoc, Transceivers.SchDoc]
2024-02-21 Processed feedback from Sintecs
    [BMS_Master.PrjPcb, STM32_IO.SchDoc]
2024-02-23 Checked BOM
    [BMS_Master.PrjPcb, Top.SchDoc]
2024-02-23 Adapted framework for G4 series
2024-02-26 I'm scared
    [Module Board.SchDoc]
2024-02-26 Another slave checkpoint
    [Module Board.SchDoc]
2024-02-26 Updated PCB to same stackup as MB
2024-02-26 Framework testing
2024-02-27 Find the mistake
    [Module Board.SchDoc]
2024-02-27 Checkpoint before risky business
    [Module Board.SchDoc, Slave.SchDoc]
2024-02-28 Design rules
    [BMS Slave.PrjPcb]
2024-02-28 More framework testing
2024-02-29 Bram pls check
    [Module Board.SchDoc, Slave.SchDoc]
2024-02-29 Some timer testing
2024-02-29 Sent to King Stefan
    [Module Board.SchDoc, Slave.SchDoc]
2024-03-05 Cool cool cool
    [Module Board.SchDoc]
2024-03-07 I hate my life
    [BMS Slave.PrjPcb, Module Board.SchDoc, Slave.SchDoc]
2024-03-11 Checkpoint time
    [Slave.SchDoc]
2024-03-11 Some more framework shit
2024-03-13 Very nice
    [BMS Slave.PrjPcb]
2024-03-14 Small PCB fix
    [BMS_Master.PrjPcb]
2024-03-18 Add BCC driver
    [BMS Slave.PrjPcb]
2024-03-23 Altium git issue
    [BMS_Master.PrjPcb]
2024-03-27 Framework fixes
2026-03-27 First push
    [BMS Slave.PrjPcb, BMS_Master.PrjPcb, Connectors.SchDoc, Module Board.SchDoc, ModuleBoard.PrjPcb, Peripherals.SchDoc, Power.SchDoc, PreCharge.SchDoc]
2026-03-27 Updated Master PCB project
    [BMS_Master.PrjPcb]
2026-03-30 Weekend work 29-3
    [BMS_Master.PrjPcb, Connectors.SchDoc, HV.SchDoc, Peripherals.SchDoc, Power.SchDoc, PreCharge.SchDoc, TempPCBs.pcblib, TempSchematics.schlib]
2026-03-30 Progress 30-3
    [BMS_Master.PrjPcb, Connectors.SchDoc, FlexBMS_lib.pcblib, FlexBMS_lib.schlib, HV.SchDoc, Peripherals.SchDoc, Power.SchDoc, STM32_IO.SchDoc]
2026-03-31 Progress 31-3
    [BMS_Master.PrjPcb, FlexBMS_lib.pcblib, FlexBMS_lib.schlib, STM32_IO.SchDoc, Transceivers.SchDoc]
2026-04-03 Progress 2-4-26
    [BMS_Master.PrjPcb, Connectors.SchDoc, HV.SchDoc, HVsense.SchDoc, STM32_IO.SchDoc]
2026-04-07 Laptop progress 6-4-26
    [HV.SchDoc, Transceivers.SchDoc]
2026-04-07 Progress 7-4-26
    [BMS_Master.PrjPcb, ESP32.SchDoc, FlexBMS_lib.pcblib, FlexBMS_lib.schlib, HV.SchDoc, Peripherals.SchDoc, Power.SchDoc, Top.SchDoc]
2026-04-08 Laptop changes 08-04-26
    [Connectors.SchDoc, Transceivers.SchDoc]
2026-04-08 Progress 08-04-26
    [BMS_Master.PrjPcb, Connectors.SchDoc, ESP32.SchDoc, HV.SchDoc, Power.SchDoc, STLink_MODS.SchDoc, STM32_IO.SchDoc, Transceivers.SchDoc]
2026-04-12 Progress 12-4-26
    [BMS_Master.PrjPcb, Connectors.SchDoc, ESP32.SchDoc, HV.SchDoc, HVsense.SchDoc, Module Board.SchDoc, ModuleBoard.PrjPcb, Peripherals.SchDoc]
2026-04-14 Progress 14-4-26
    [BMS_Master.PrjPcb, FlexBMS_lib.pcblib, FlexBMS_lib.schlib, HV.SchDoc, HVsense.SchDoc, Module Board.SchDoc, ModuleBoard.PrjPcb, Power.SchDoc]
2026-04-15 Progress 15-4-26
    [BMS_Master.PrjPcb, FlexBMS_lib.pcblib, FlexBMS_lib.schlib, Module Board.SchDoc, Slave.SchDoc]
2026-04-20 Progress 19-4-26
    [FlexBMS_lib.pcblib, FlexBMS_lib.schlib, Module Board.SchDoc]
2026-04-20 Progress 20-4-26
    [BMS_Master.PrjPcb, Module Board.SchDoc]
2026-04-22 Progress 22-4-26
    [BalancingNetwork.SchDoc, Module Board.SchDoc, ModuleBoard.PrjPcb, Slave.SchDoc]
2026-04-26 Ready for Arjan's magic
    [BMS_Master.PrjPcb, BalancingNetwork.SchDoc, Connectors.SchDoc, ESP32.SchDoc, FlexBMS_lib.schlib, HV.SchDoc, HVsense.SchDoc, Module Board.SchDoc]
2026-04-27 Progress 27-4-26
    [ESP32.SchDoc, Module Board.SchDoc, ModuleBoard.PrjPcb, Peripherals.SchDoc, Power.SchDoc, Transceivers.SchDoc]
2026-05-07 Progress 07-05-26
    [FlexBMS_lib.schlib, Module Board.SchDoc, ModuleBoard.PrjPcb, Slave.SchDoc]
2026-05-12 Progress laptop
    [Module Board.SchDoc]
2026-05-12 Progress 12-5
    [BMS_Master.PrjPcb, ESP32.SchDoc, Peripherals.SchDoc, STM32_IO.SchDoc, Top.SchDoc, Transceivers.SchDoc]
2026-05-15 Progress 14-5-26
    [FlexBMS_lib.pcblib, FlexBMS_lib.schlib, HV.SchDoc, Module Board.SchDoc, ModuleBoard.PrjPcb]
2026-05-22 Progress 21-05-2026
    [BMS_Master.PrjPcb, FlexBMS_lib.pcblib, Master - OLD.PcbDoc, Module Board.SchDoc, ModuleBoard.PrjPcb]
2026-05-27 Module board finished
    [BMS_Master.PrjPcb, Connectors.SchDoc, ESP32.SchDoc, FlexBMS_lib.pcblib, FlexBMS_lib.schlib, HV.SchDoc, HVsense.SchDoc, Master.PcbDoc]
2026-06-01 Progress 31-5-26
    [BMS_Master.PrjPcb, FlexBMS_lib.pcblib, Master.PcbDoc, Transceivers.SchDoc]
2026-06-09 Progress 9-6-26
    [BMS_Master.PrjPcb, FlexBMS_lib.pcblib, HV.SchDoc, HVsense.SchDoc, Master.PcbDoc]
2026-06-15 Progress 15-6
    [Connectors.SchDoc, ESP32.SchDoc, FlexBMS_lib.pcblib, FlexBMS_lib.schlib, HV.SchDoc, HVsense.SchDoc, Master.PcbDoc, Module Board.PcbDoc]
2026-07-08 Update Australia
    [BMS_Master.PrjPcb, Connectors.SchDoc, ESP32.SchDoc, HV.SchDoc, Master.PcbDoc, Module Board.PcbDoc, Power.SchDoc, Top.SchDoc]
2026-07-09 Progress 9-7-26
    [BMS_Master.PrjPcb, ESP32.SchDoc, FlexBMS_lib.pcblib, Master.PcbDoc, Module Board.PcbDoc, Module Board.SchDoc, ModuleBoard.PrjPcb, STM32_IO.SchDoc]
2026-07-13 Progress 13-7
    [BMS_Master.PrjPcb, BalancingNetwork.SchDoc, Bill of Materials-ModuleBoard.xlsx, Connectors.SchDoc, ESP32.SchDoc, HV.SchDoc, HVsense.SchDoc, Master.PcbDoc]
2026-07-15 Update 14-7
    [BMS_Master.PrjPcb, Module Board.PcbDoc, Module Board.SchDoc, ModuleBoard.PrjPcb, STM32_IO.SchDoc, Slave.SchDoc]
2026-07-16 Progress 15-7
    [ESP32.SchDoc, FlexBMS_lib.pcblib, FlexBMS_lib.schlib, Power.SchDoc, Transceivers.SchDoc]
2026-07-16 Progress 16-7
    [BMS_Master.PrjPcb, Connectors.SchDoc, ESP32.SchDoc, FlexBMS_lib.schlib, Master.PcbDoc, Peripherals.SchDoc, Power.SchDoc, STM32_IO.SchDoc]
2026-07-17 Release V1.0
    [BMS_Master.PrjPcb, Bill of Materials-ModuleBoard.xlsx, HVsense.SchDoc, Master.PcbDoc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]
2026-07-19 Released HW V1.0.1
    [FlexBMS_lib.pcblib, Master.PcbDoc, RelayDriver.SchDoc]
2026-07-29 Removed legacy files
    [BMS_Master.PrjPcb, Master - OLD.PcbDoc, Module Board - OLD.PcbDoc, ModuleBoard.PrjPcb]
2026-07-29 Failure handling and documentation
    [SlaveController.cpp, SlaveController.h, bcc.cpp, bcc.h]
2026-08-12 Implement STM32 UART v1
2026-08-13 Implemented UART, LEDs, and WiFi
2026-08-13 Integrated companion
    [partitions.csv]
2026-08-14 Implemented Release bundle, FW update, companion improvement
    [partitions.csv]
2026-08-17 Fixed ADC bug
2026-08-19 Implemented MQTT & Improved UART stability
    [BmsUart.cpp, BoardIO.cpp, FaultManager.cpp, GatewayApi.cpp]
2026-09-01 Removed I2C legacy code
2026-09-06 Fixed precharging & static settings
    [GoodweCan.cpp, RuntimeConfiguration.cpp, SlaveController.cpp, UserSettings.h]
2026-09-06 Potential fix for diagnostic reboot loop
    [SlaveController.cpp, bcc_diagnostics.cpp, bcc_diagnostics.h]
2026-09-06 Improved recovery mechanism ESP32
2026-09-07 WiFi improvements & UI fixes
    [GatewayApi.cpp, SlaveController.cpp]
2026-09-07 Added power as a field
2026-09-07 Implemented voltage derating
2026-09-09 CAN diagnostics + CAN fix
    [BmsUart.cpp, GatewayApi.cpp, GoodweCan.cpp]
2026-10-06 Release v0.1.74: safety policy diagnostics and BMS accuracy improvements
    Reorganize Companion diagnostics and expose firmware safety limits. Include temperature derating and inverter-limit enforcement, balancing telemetry, self-discharge and current accounting improvements, transport reliability updates, tests, documentation and generated Gateway assets.
2026-10-17 Release v0.2.2 with acquisition-based BMS telemetry
2026-10-17 Fix startup diagnostics for configured temperature inputs
    Ignore open unused GPIOs while retaining raw diagnostic masks. Reinitialize the monitor chain after failed diagnostics, preserve the first failure, and expose register context through the Gateway and Companion.
    Add GPIO/retention and report-decoding coverage, a read-only Gateway capture script, current operating documentation, and regenerated v0.2.4 artifacts.
2026-10-18 Fix BCC conversion waits across timer rollover
